Cailynoo7/makit-project-6/design/helicopter-lamp/README.md

# helicopter-lamp

## Must satisfy

## Making and assembly

## Open
