Cailynoo7/makit-project-6/design/keys/source/models/SOURCES.md

# SW1 mechanical reference

Exact identity Kinghelm KH-6X6X4.3H-STM/C2837530. Supplier footprint and electrical source are unchanged. This is an explicitly drawing-modeled conservative external envelope, not an original manufacturer STEP; arbitrary cover/lead detail does not define copper. Height H4.3mm, plunger diameter3.5mm, travel0.3+/-0.1mm come from the exact manufacturer drawing. The prior supplier STEP had5.01mm above its lead seating plane and is not the height authority.

Drawing URL: https://datasheet.lcsc.com/datasheet/pdf/3a63fc257cb630e20c8ec53c2547a77a.pdf?productCode=C2837530
Drawing SHA256:5686a865fc368784abc6e8805e710e62f4395d8b7a8c39ed3d3ddb1714d7a0b2

Generated by source-owned CAD design switch_reference, revision c9949165412c38a6ac5ab94769f7da9cb6df7377e4d89cbc662046b82f593c10, handoff export-7d7ee1b4b75383cb56aa28204cc8e3bd. Model lead seating plane is z0; overall height is4.3mm. Extra mounting gap parameter is0: the PCB exporter supplies its own mounting datum, which must not be counted twice. Model SHA256:80513fc8b36095e813428bed6e5761dc41643385bb0ecd3eed9ce8c9b031f12c

Internal project model; no third-party STEP licence claimed. Verify actual mounted height/press feel on first assembly.
