Cailynoo7/makit-project-6/product/铝件加工说明.md

# 一体金属热桥加工要求

本结构使用一件整体铝合金热桥，包含COB安装台、左右分支和贴壳接触面；不再分别加工或安装原AL01–15零件。历史15件加工图不适用于本结构。整体模型已通过几何和指定装配路径检查；作为加工规格仍须制造方确认工艺、可达性及报价。

默认沿用1050/1060铝材的导热用途。单件复杂曲面及薄接触区需要加工商确认可制造性、装夹、薄壁变形与报价；不把CAD单一实体视为制造工艺已确认。不要将塑料件或任意低导热材料替代金属件。

保持两处COB支座安装通孔、光源粘接面、螺钉头及工具避让。无需旧M1.6接触座螺纹和M2桥根夹紧螺纹。默认一般线性±0.10mm，孔位及配合接触尺寸±0.05mm，平面安装面平面度0.05mm；装配限制轮廓只能向少材料方向0.10mm。贴壳接触区不得加厚涂层或毛刺，去毛刺时不削薄接触边。

与塑料壳间保留薄层电绝缘非固化导热材料，COB与金属平台使用原绝缘导热胶。所有薄层厚度和实际接触压紧均需试装验证，不用厚胶补偿形状错误。三路温控和热稳定照度验收仍保留。
