Cailynoo7/makit-project-6/product/首样下单与供应商交样要求.md

# 自行制作首样的采购与检查

产品由用户自行制作、接线、烧录和装配，不购买厂家上下功能总成，不安排整机预装、代接线、代烧录或代校准。散件按采购清单购买。电芯选择带点焊引线规格，不在裸电芯上直接锡焊。

PCB沿用当前制造版本和原六层铜厚规格；裸板并不包含焊接元件。按元件方向、电源分区和结构化接线表自行焊接、检查短路及逐线导通。两个按键小板、三路NTC、灯驱动、电机限流和电池保护保留。

打印PETG壳体、托架、电池座及带集成承托的XIAO卡座；白色ASA反光罩与两只灯源支座一体打印，取消这两处胶接。单条25mm无扣绑带固定电池，端挡及两颗螺钉保留。充电试件使用与整机相同的集成承托高度，参考1.0mm板为0.6mm；实际1.6mm板用0mm。

15件铝件仍按同版STEP及已有加工图制作，材料1050/1060。保留金属攻牙、成形内衬和指定薄热界面，不能用打印件替代。散热片、热桥、探头均由用户安装。

按装配说明逐步组装，遵守主托架、电池座和侧窗的先后关系。合盖前确认旋翼自由转动、皮带不碰线、按钮无预压、USB可插拔、线束不被夹住。

通电后按已有校准与首样测试表记录实测数据：独立按键、USB关闭两负载、探头故障关闭、温控、灯扇同开、照度、风量、磁吸保持及振动。读写目标仍为300mm安装高、400×300mm区域平均500lx/最低300lx、最大最小比≤3，并要求热稳定后满足；当前未有实测通过记录。
