Cailynoo7/makit-project-6/product/function-review.md

# 风扇与灯功能核查

核查日期：2026-11-12。250mm旋翼的电机、传动、驱动及内部装配已形成可复算的理论方案；实际风量、噪声、温升和寿命仍未验证。阅读灯已选定具体COB、升压驱动及3200mAh18650；连接板电路与接线已更新并通过裸板制造检查；内部导热、电池固定、连接板托架及温度控制固件已实施并通过相应模型/程序检查，整灯光学与热稳定未验证，不能认定新版整机可直接采购装配运行。保持用户认可的外观。

## 风扇

- 供电：保护型1S电池分支→J_BAT→DRV8213RTER H桥→Pololu3060；XIAO只输出逻辑信号。新TPS61500照明支路独立，共用保护后电池。
- 选定Pololu3060、5:1 HPCB6V无编码器，厂家减速箱12×10mm、3mm D轴。6V空载6500rpm±20%、170mA±50%，理论堵转8.826mN·m、1.5A，最大机械功率约1.3W；这些不是单节电池下的输出。建议持续电流不超过额定堵转电流25%，即0.375A。
- 电机内部实际4.995:1，皮带有效轮径30/8mm、3.75:1，总减速18.73125:1。轴承及250mm四叶、37.5mm最大弦宽、1.6mm厚、12°桨距均不变。O形圈改32×1.5mm EPDM70A，中性线名义伸长5.526%；端板2颗M1.6×3，长孔允许±0.3mm微调。D轴承担扭矩，微量环氧点固只作轴向保持；先校准打印孔，不敲打电机轴。
- 可复算叶素动量模型使用显式假设的低雷诺数升阻系数，叠加近顶壁、轴承及皮带损耗，匹配厂家端点的单节电池外推曲线。60%驱动/制动PWM，在3.3/3.7/4.2V下名义旋翼411/458/514rpm、绕组电流0.261/0.276/0.297A。高负载敏感性算例4.2V电流约0.371A，已接近0.375A验收值；厂家空载电流和转速离散性尚未转为合格保证。不能直接启用100%占空比：名义满电估算795rpm、0.437A已超过持续电流建议。
- 皮带模型取弹性模量3–10MPa、摩擦系数0.3–0.7作假设敏感性，名义扭矩能力7.18mN·m，低假设2.73mN·m；实际硬度、松弛、污染和摩擦未测。名义电机径向负载约0.98N，同样需要寿命与轴套温升验证。不能把该估算当作O形圈厂家的性能保证。
- 驱动IN1接D3/GPIO5反相20kHz PWM，IN2接D5/GPIO7的J7.1使能；运行时IN2高、IN1高40%得到60%电机驱动与40%低侧制动，关闭两输入低至少10ms。新增D5/地线对完全在机舱内。按从上方看逆时针校准电机两线，形成向下送风。
- IMODE高、GAINSEL低、SMODE低，IPROPI4.99k，VREF为150k/22k分压；限流阈值3.3V约0.413A、4.2V约0.525A。470nF给出名义3.055s启动忽略窗口，之后过阈值会锁存关断；关闭再开复位，不自动反复启动。限流阈值不是持续电流额定值，也不能保护所有低于阈值的机械过载。
- 原RF300CA及同外形RF300FA只保留为比较证据，不列为现用动力。Pololu3060官网查询为待补货；通用N20不能按外形直接替代。

## 灯

- 已选成品COB光源：鸿利HL-LM002H384W-5B2C5(Ra2)(ANSI-4000K)，LCSC C22398553。自带铝基板13.5×13.5×1.5mm，发光面Ø11.2mm，4000K/Ra≥80。300mA、基板25℃下流明570/620/680，Vf14/16/18V；不能把这组目录光通量直接当成最终桌面照度。
- 新供电路径：18650→保险与1S保护→TPS61500升压恒流→COB，风扇走独立DRV8213分支。采样0.75Ω1%得267mA名义电流，含参考与电阻公差范围257–276mA，光源名义约4W。原MEL7135/Q2及旧1kHz50%程序不能使用该14–18V光源。
- 最坏计算采用LED电压18V再加3%测量容差、FB0.205V、效率80%、驱动输入3.0V、电感8µH和频率480kHz敏感性假设：输出5.175W，平均输入2.156A，开关峰值2.486A，小于芯片3A最小开关限流。整机另计风扇0.35A及主控0.12A，总预算2.626A。频率、效率、启动浪涌、限流和稳定性仍需样机确认。
- DIMC=1µF选择模拟调光，EN可接5kHz控制；启动必须先连续高电平50ms，再按温度降占空比。TI第11页写启动最小PWM导通200µs，不能用不足200µs的低占空比5kHz脉冲代替启动。关断保持EN低至少10ms。
- 读写目标默认30cm高、40×30cm区域平均≥500lx、最低≥300lx、最大/最小≤3。水平朗伯出光估算需要至少244lm有效向下光通量；260lm例子得到平均633lx、边角320lx。这是光学预算，并未证明最终打印罩和电池遮挡后能得到260lm。
- 热路径改为铝集热件、两条短宽铝导热带及实际72.1cm²贴壳均热片；不新增外孔或外露散热片。三点NTC及ADS1115监测灯源、壳面热点、电池。均热面积、接触热阻和壳面外侧换热尚未测定；降功率后的稳定亮度仍必须达到照度目标。
- 18650预留包络Ø19×66.2mm、横向Y轴、中心[0,0,-24]。相对现有结构的只读网格预检最小间隙约0.505mm，网格公差0.02mm；现版另有独立固定座、完整线束及分阶段装拆检查，见内部收尾评审。现版18×34×3mm集热板、ASA支座、桥和托架已完成实体适配，旧预检不用于现版验收。

## 共用能源、按钮与充电

- 使用XIAO ESP32C3自带Type-C与约380mA充电电路，不另加充电模块。用户已选3200mAh18650；具体电芯FLY.18650.3200.3C，最大Ø18.6×65.2mm、46g，裸电芯不带保护。供应商点焊引线，使用新版连接板BQ29700与并联背靠背MOS及4A熔断器；XIAO的BAT端、GND及负载全部接PACK侧，禁止电芯负极直接接XIAO绕过保护。电机与灯不从XIAO3.3V取电。原103040及1.5A保护电池采购要求已失效。灯单开约1.5–2小时、同时约1.2–1.6小时、充电约9–11小时均为估算。
- 左右各一块14×18mm按键板，J1.1=KEY、J1.2=GND；KH开关同侧A/B是一组，C/D是另一组。已修正接线表此前混用裸开关脚号的错误，不能把裸开关1与3当作两个不同触点。
- 充电检测已修正：R5上臂100k，R6下臂由100k改为150k、1%。5V时得到约3.0V；4.4V、最坏1%电阻公差时仍≥2.619V，高于3.3V GPIO的0.75VDD=2.475V保证高电平门槛。5.5V、最坏电阻公差时≤3.327V。GPIO10必须设置INPUT且不启用内部上拉/下拉；C4=100nF对应约6ms时间常数，程序采用高电平立即关断、低电平连续500ms后才解除禁止的处理。
- 程序已适配TPS61500的50ms连续启动/5kHz模拟调光，以及ADS1115三路NTC和电池电压采样；保留独立按键、DRV8213反相20kHz和USB负载关闭。35组测试/11329次断言通过，真实XIAO_ESP32C3编译通过（314386字节程序、14312字节静态RAM），未烧录或测波形。温度/ADC/探头/电压异常关闭负载，恢复需重新按键；程序不能停止原XIAO充电器。USB检测是软件互锁，不是硬件电源隔离。

## 验证与限制

- 旧连接板ade1797099dda888c56afeca8b9f904bfcdfbd4dd045d05e4b9c98c2fe10cd1c（不适用于新COB）：0DRC错误、0未连接项、7丝印警告，2层1oz，过孔0.6/0.3mm。制造和机械资料均已生成；元件仍按手工或委托回流焊装配，空的JLC SMT清单不构成包焊订单。WQFN散热焊盘及C5/C6地端过孔须检查焊接。
- 厂家电机STEP及新板装配模型已导入。已确认的外观未变，电机、托架、皮带轮及板均无新增静态相交；按键开关参考改为厂商H4.3mm图纸的保守装配外形，实板采购身份和焊盘不变；两侧顶杆留0.15mm空隙，0.45mm总位移对应0.30mm开关动作，止挡随内部压环拆卸。静态与按压/拆装路径未发现穿透，实际公差、回弹及手感仍需试件。
- 旋翼360°与托架带新电机的斜向检修路径均未见穿透；检查网格公差0.02mm，旋转最大点行程2mm、拆装0.5mm。完整线束现已按尺寸包络检查；打印误差与实物插合仍须确认。
- 新增两颗M1.6×3电机螺钉。承重M4×90 ISO10642的完全匹配现货仍需询价，不用圆柱头或DIN965替代。磁吸保持力、整机温升及光学性能未验证。

## 证据

- 现用电机：https://www.pololu.com/product/3060
- 电机厂家手册：https://www.pololu.com/file/0J1487/pololu-micro-metal-gearmotors-rev-6-2.pdf
- 驱动器：https://www.ti.com.cn/cn/lit/ds/symlink/drv8213.pdf
- XIAO供电与充电：https://wiki.seeedstudio.com/XIAO_ESP32C3_Getting_Started/
- XIAO引脚：https://files.seeedstudio.com/wiki/XIAO_WiFi/XIAO_ESP32-C3_front_pinout.png
- ESP32-C3数字输入电平：https://documentation.espressif.com/esp32-c3_datasheet_en.html
- MEL7135：https://datasheet.lcsc.com/datasheet/pdf/05432fb6d6b74673b053705b65285d53.pdf?productCode=C80214
- OSRAM候选灯珠：https://item.szlcsc.com/57658993.html
- OSRAM数据表（最大额定第4页、电特性第5页）：https://datasheet.lcsc.com/datasheet/pdf/4ebd874a5a3144677ed6206ea510a039.pdf?productCode=C54351703

控制程序及内部结构已同步，保持现有外观；下一步完成局部装配和探头校准。随后以实际透光罩进行热稳定照度、电池温升、充电关断和磁吸承载测试。硬件选型与计算可供改版使用，旧制造包不能直接制造新版阅读灯。

阅读灯证据与计算：COB、TPS61500、NTC及电芯供应商PDF均已归档；选型核查中逐项记录页码、原文与图示核对结果。

## 本版连接板验证

现版171fcced主板40×50×1.6mm、六层外1oz/内2oz、76器件完整模型保留。F1间隙0.715mm；J10/J11针脚未变。现版14只插座、H01–H12完整路线和21组分阶段检修已检查，详见内部光学与装配评审，不沿用旧临时线束末端或旧路线间隙数值。

## 当前收尾状态（2026-11-13）
采用现用171fcced主板与53c419c4按键板。保持已确认外观；本次只增加白ASA内反光罩、完整线束参考和可拆线束夹，修改卡座隐藏出线槽与铝桥R4线槽。静态104物体5356对零共享体积；12主板插壳和2窗端插座按分阶段0.5mm精确几何拔出检查无相交。21组刚性检修检查已复核，须断电并释放/停放柔性线。铝件15件、40.083g、内衬等效72.137cm²；前下透光口未改。

新资料可以用于首样加工询价和受控装配；未宣称光学/散热实测合格。固件既有主机和目标编译结果保留，接线仅追加路由标签；不改变引脚、温控或程序。必须以封壳热稳定照度、温度校准、旋翼绕组RMS电流/风量、磁吸承载验收实际首样。
