Cailynoo7/makit-project-6/product/reading-light-review.md

# 阅读灯光源、驱动、散热匹配

用户要求保持已确认的外观，独立照亮读书写字区域，取消20mm灯板与0.5W限制；用户选择3200mAh单节18650。本文落实器件和工程预算，连接板及接线已更新并通过裸板制造检查，电池座/导热CAD及温控固件已同步，实物热稳定照度尚未验证。

## 具体选型

|用途|选定身份|主要依据|
|---|---|---|
|成品COB光源|鸿利HL-LM002H384W-5B2C5(Ra2)(ANSI-4000K)，C22398553|自带铝基板13.5×13.5×1.5mm，发光面Ø11.2mm，4000K、Ra≥80；300mA、25℃下570/620/680lm，14/16/18V|
|恒流升压|TI TPS61500PWP，C1554283|输入2.9–18V，反馈200mV，3A最小开关限流；使用DIMC电容选择模拟调光|
|电感|奇力新MHCC06030-100M-R7，C280564|10µH±20%、DCR最大68mΩ、典型Isat5.5A/Irms4A；7.3×6.6×3mm|
|整流|Vishay SS3P6L-M3/86A，C968580|60V、3A肖特基，反压高于驱动芯片40V开关额定值|
|温度采集|TI ADS1115IDGSR，C37593|3.3V、四路ADC，三路NTC加电池电压|
|成品探头|宏嘉诚HNTC-103F3950FB-100P，C52204608，3个|10kΩ±1%、B3950K±1%、100mm引线；探头最大Ø2.8×7.5mm|
|电芯|远阳FLY.18650.3200.3C，C5289740|3200mAh典型、3100mAh最低，3.6V，最大Ø18.6×65.2mm，46g；裸电芯不含保护|
|电池保护|BQ29700DSER、5组并联CSD85301Q2背靠背MOS、0451004.MRL熔断器|过充、过放、过流及故障后备；XIAO及全部负载必须接保护后的PACK侧|

光源是工厂已封装在铝基板上的COB，无须用户另外寻找焊好裸灯珠的20mm星形板。小基板并不固定灯的低功率；本方案名义约4W，实际亮度由电流、光效、温度与透光系统共同决定。

电感供应商资料标注该系列不推荐新设计，允许现有库存原型使用，未作量产生命周期批准。各关键件暂无核验过的直接替换型号；原型须保持确切料号和COB的4000K/Ra2版本。查询时COB库存37、电芯72，库存会变化。

## 电气预算

- 0.75Ω±1%采样电阻配195–205mV反馈，名义266.7mA，范围257.4–276.1mA；采样耗散约0.057W，默认1206、至少0.25W。光源正常约4.1W，温度反馈按需降低电流。
- 最坏算例采用LED18V再加3%测量容差、反馈0.205V，输出约18.745V/5.175W；80%效率、驱动端3.0V时平均输入2.156A。8µH及480kHz敏感性假设下开关峰值2.486A，距3A最小开关限流约0.514A。600kHz实际频率离散、效率、偏置后电感值须实测；3A不是灯的输出电流。
- OVP分压158k/10k、均1%，包括基准误差为19.65–21.67V，高于上述输出；输出电容默认两颗2.2µF/50V、1210、X7R，需在21.7V下合计有效至少2.2µF。输入就近4.7µF/10V，SS47nF、COMP470nF、FREQ176kΩ，输出1MΩ泄放。普通阻容按这些公开默认值选标准封装，供应商偏压曲线在PCB落实时核对。
- DIMC接1µF；GPIO6/D4直接控制EN，减光时用5kHz。启动先连续高电平50ms再调光，关断至少低10ms。TI规定启动最小PWM导通200µs，不能把不足200µs的5kHz低占空比脉冲当成有效启动保证。
- 加风扇0.35A和主控0.12A余量，最坏电池电流预算2.626A，低于电芯全温区列出的3.1A持续电流。5组背靠背MOS并联用于降低单节电池栅压下的导通电阻；电流均分、热态电阻、保护动作与熔断器配合仍须验证。
- ADS1115使用AIN0灯源温度、AIN1壳体热点、AIN2电池温度、AIN3电池100k/100k分压；ADDR接地为0x48，100nF去耦，I²C上拉4.7kΩ。显式指定XIAO D7/GPIO20为SDA、D6/GPIO21为SCL，100kHz；默认I²C的GPIO6/7已被灯扇占用，不能直接沿用默认总线。
- 保留左右独立按钮及原DRV8213反相PWM，USB存在时关闭两负载，拔线稳定500ms后须重新按键。新增的是内部三线ADC接口、三路NTC接口和保护后XIAO电池线，不增加外部开口。

## 光学预算与验收

工程默认：透光底面距桌面30cm，40×30cm读写区，平均至少500lx、最低至少300lx、最大/最小不超过3。此矩形和高度不是GB/T9473认证测试声明。

用水平朗伯出光模型：`E=Φ有效·h²/[π(h²+x²+y²)²]`，401×301梯形网格积分得到每流明有效向下出光对应中心3.537lx、区域平均2.436lx、边角1.232lx，需至少243.54lm。260lm例子对应中心920lx、平均633lx、边角320lx，最大/最小2.87。

降低电流并考虑温度后的COB约400–500lm仅为工程估算。若源光400lm、65%成为有效向下出光，则上述预算可达标；若只有55%，边角约271lx，会失败。不能把65%耦合效率写成既成事实。光束需主要向下，内部白色反射件优先把光导向原底透光面，前透光面保持柔光；必须计入18650遮挡和打印透光罩损耗。原向前45°安装不继续作为阅读灯方向。

## 封闭机身的散热

保持无额外外孔及外露散热片。COB通过12×12×0.15mm绝缘导热胶接18×34×3mm集热板；经左右可拆铝桥、四只球面接触座及两只上盖连接件接六片0.5mm内衬。胶k≥1.5，非固化填料k≥3；多处0.1mm可拆热界面不得永久胶死。15件铝理论净重40.083g。

六片内衬体积/厚度等效面积72.137cm²，不是外部有效换热面积。旧180cm²构想的铝带/壳壁/外界换热数字已撤回，不作为现版估算。COB胶层一维理想热阻约0.694K/W，只是这一胶层，不能代替整条热路与局部热点实测。

默认灯源60℃开始降功率、70℃关闭，壳面43℃开始降功率、48℃关闭，电池40℃开始降功率、45℃关闭；三路传感器异常、ADC离线或电池低于3.3V关闭两路，恢复须重新按键。探头的安装热滞后需实测。XIAO原充电器没有已建立的软件充电关断接口，这些NTC逻辑关闭负载，不能冒称能停止充电；电芯充电环境仍要求0–45℃并验证实物温升。

必须把热稳定后的读写照度作为验收。连续记录至少60分钟且温升小于每10分钟1℃，测试灯单开与灯扇同时、满电与低电量、25℃并做35℃暖环境敏感性。若降功率后不达照度目标，继续改内部均热或光路，不能降低用户要求。

## 电池与内部装配

使用点焊包覆后Ø19×66.2mm的3200mAh电芯，轴Y、中心[0,0,-24]。独立托座、双绑带、缓冲端挡、硬定位与可拆端盖均已落实。COB、支座、桥、内衬、线束和安装件在现版静态检查无共享体积；分阶段拆装须先断电、解除绑扎并停放柔性支线。磁铁仍Ø30×2，须用完整样机重量及振动实测保持力。

约4W灯源下估算灯单开1.5–2小时、灯扇同时1.2–1.6小时；沿用XIAO约380mA充电，3200/380仅恒流阶段理想值8.42小时，含恒压及损耗预计9–11小时，均非实测承诺。

## 证据与实施边界

- COB供应商PDF第2–5页：基板、尺寸、电气/光学与温度曲线。
- TPS61500 PDF第3、5–6、10–15、18–19页：引脚、额定条件、模拟调光、外部元件及布局/热要求。
- 电芯PDF第4、7–8页：容量、外形、充放电条件与禁止直接焊接。
- ADS1115 PDF第3–5、11、23页：电平、模拟范围、总线及典型应用。
- NTC PDF第1、3页：电阻/B值、热响应及成品探头图。
- BQ29700 PDF第4–8、21–22页、CSD85301Q2第1、3–4页及4A熔断器第1–2页：保护、MOS连接和电阻、电流与熔断特性。熔断器目录I²t与PDF不一致，使用PDF的3.152A²s。
- XIAO引脚来自官方索引所载Espressif变体定义，D7=20、D6=21；程序需显式重映射I²C。

已将具体选型和计算同步到配件清单、约束及采购说明。连接板与接线已实施；内部电池座、导热组件、托架及温控程序已实施；下一项为实物装配、温度校准及热稳定照明验证。新版连接板裸板资料已生成，旧MEL7135制造包不得混用；现有固件已适配新COB/ADS1115/三路NTC，主机测试与XIAO目标编译通过，实物验证待完成。

## 当前内部收尾版本
反光罩/前混光口、完整线束和15件铝加工资料已落实到现版。铝净重40.083g；六片0.5mm内衬等效面积72.137cm²，任何180cm²概念的热阻结论不适用。反光罩哑白ASA厚1.6mm，16×2mm内部前混光口、25°遮光片；底透光片及前透光片尺寸不变。选取的4条COB至底片直线路径无遮挡，不代表光效或眩光验证。最终500lx/最低300lx/均匀性和热稳定必须用实物透光件检查。完整当前结论见内部光学与装配评审，旧概念和原始选型计算不作为现版热验收。
