Cailynoo7/makit-project-6/product/usb-fit-review.md

# 充电口与XIAO局部适配核查

2026-11-12。已取得并导入社区XIAO ESP32C3 STEP，完成模型装配和局部试件。仍需实物试装，社区模型不等于厂家尺寸认证。

## 模型来源与核对
来源：vinjocarsales/xiao-series0.1.7，assets/xiao-esp32-c3.step。
https://tscircuit.com/vinjocarsales/xiao-series/blob/assets/xiao-esp32-c3.step
下载：https://api.tscircuit.com/package_files/download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
SHA256：d3eb22a99dade7b2fb6ccc2ac102d9a5a5fac6c92ef4d58a8c496357b1ae3735。
模型31个实体，PCB20.955×17.78×1.0mm，整板含连接器22.463×17.78×4.21mm。板框与官方v1.3 PCB边界一致，连接器口沿相对板中心前伸11.9855mm，与官方USB0丝印平面包络吻合。不能用丝印替代实体机械图；此次高度取自社区STEP实际前口环面，尚未由实物证明。
官方wiki：https://wiki.seeedstudio.com/XIAO_ESP32C3_Getting_Started/
官方PCB：https://files.seeedstudio.com/wiki/XIAO_WiFi/Resources/XIAO_ESP32C3_v1.3_KiCad_260116.zip
官方工程文件名义板厚1.6mm，社区模型板厚1.0mm，版本差异未由实物确认。公开元件库未标模型许可，保留原来源，仅作项目装配参考。

## 定位与适配
外部开口中心保持[42.555111,0,-26.25]mm，仍比原位置上移10mm，插入方向+X。小口9.7×4.0mm，包胶凹位13.3×7.3mm、R0.5，中心处凹深4.75mm。
STEP原生板框中心X=1.8041587、横向中心Z=-6.1114，PCB下表面Y≈0；USB口沿X=13.7896587、口心Y=2.605。原生+Y为元件面、+X为USB方向。
板模型旋转X=90°，平移[24.01545264,-6.111399955,-28.855000015]，得到USB口心[37.805111,0,-26.25]，与设计接口目标重合。
卡座较此前沿机头方向移动1.4855mm，支承面抬高1.395mm，并加0.6mm可拆垫片。对模型中的1.0mm板，板下表面Z=-28.855、上表面Z=-27.855；实板若为1.6mm，不用0.6mm垫片，保持板顶面相同。夹槽总厚1.9mm，板+垫片总厚1.6mm，余量0.3mm。换板后还需检查是否同一连接器及元件布局。

## 局部试件
独立设计charging_fit，三件打印件：局部球壳、与整机相同的卡座、0.6mm垫片。两颗M1.6×5内六角机螺钉可复用整机件，主控板模型和螺钉不打印。
球壳约25.55×46×20.25mm；卡座约22.95×40×6.60mm；垫片20.5×17.2×0.6mm。
试件球壳与整机同一裁切区域的精确几何差为0；卡座、垫片与整机的双向体积差为0。比较使用整机0e3c71b快照，临时完整对比装配已从试件设计移除。

## 已完成的检查
- 整机参考板与机壳、卡座、垫片精确共同体积均为0；试件没有相交零件。
- 模型口心与目标坐标一致。参考板沿-X滑出25mm的路径无穿透；与卡座最小网格间隙约0.1304mm。
- 卡座连同板和垫片先-X10mm、后-Z20mm取出未见穿透；拆装路径0.5mm步长、0.02mm网格公差。
- 包胶量规15×12.35×6.5mm，横向±0.25mm、竖向±0.30mm四组合，推入20mm并以0.5mm取样，与试件壳体精确共同体积均为0。
- 按键供应商模型高度偏差已在后续4.3mm装配包络版本修正；按压实物手感仍须试件。

## 实物通过条件
用PETG按0.2mm层高试做三件，垫片为3层。装入裸板，1.0mm板加垫片、1.6mm板不加；从机头侧滑入板，勿强压板上器件。确认板边不晃、卡座无明显弯曲，再插入拟用直头USB数据线。插头须能完全就位，包胶不顶外壳，插拔不能带动卡座。随后检查USB供电/电脑枚举。插入力、端子接触、打印公差及焊线后的空间仍由实物试装确认。

## 本次同步
整机与局部卡座同时增加D6/D7/VBUS三处R1焊线槽，槽心[18.1361,±7.62]/[33.3761,-7.62]、Z=-26.2、高4.2mm。外部USB口和卡座最大包络不变。两者实体体积均622.533137mm³；试件当前4cdc95c5，整机47a887e8，原球壳和垫片未改。实物试装须带上最终焊线，确认出线槽不压线。
