Cailynoo7/makit-project-6/product/结构重构评审.md

# 左右分壳与单一内架结构重构

用户自行接线、组装，无厂家功能总成预装。六片独立均热片全部取消，原十五件散热金属件合并为一件连续金属热桥；电池鞍座、充电板支承、主板/电机承托和束线导向合并为一件PETG内架。反光罩因材料及光学功能保留为一件ASA零件。

|项目|重构前|重构后|减少|
|---|---:|---:|---:|
|散热金属件|15|1|14|
|热桥相关螺钉|8|2|6|
|独立支承件|4|1|3|
|充电板卡座螺钉|2|0|2|
|托座固定扎带|2|0|2|
|内架固定螺钉|2|1|1|
|合壳螺钉|3|2|1|
|尾梁螺钉|2|1|1|

相对重构前版本1ed13b5，独立结构件和紧固件共减少30件。消耗性胶带、胶层、线束端接及固化等待另计；XIAO导轨滑入后增加一处可剥离绝缘胶带止退。未测量装配时间，不把装配说明卡合并当作手工动作减少。

装配工作集中到壳外：主板、电机、电池、光学与热桥在线架上就位，接线检查后整架侧装，一个定位销与一颗M2×6固定。两颗M2×8沿左右方向拉紧拼缝，前上锁点经前口、后下锁点经底口操作；后部一体舌槽先定位；固定半壳独立承担顶部M4承重连接，开侧壳不松吊杆。尾梁短插头内置防转平面，一颗固定侧螺钉锁紧，外露圆肩不变。

指定装入、开壳、主板、热桥、电芯、端挡、充电板和螺钉路径的固定对象、前提及结果以结构化验证记录为准。网格公差0.02mm，路径采样最大步长0.5mm。柔性线束必须先断开、释放并停放，不能宣称会自动随刚性组件运动。工具检查同时考虑直达和六角扳手转动空间。

三路测温、电池保护、充电互锁、绝缘导热胶层和原读写照度要求全部保留。实体连续性和接触面积不能证明温升合格；平均500lx、最低300lx及均匀度不大于3的目标不降低。

这种减件方式把部分装配工作转移为复杂的一体金属件制造。整体热桥需要加工方确认成形/加工可达性、薄接触面变形和报价，不能按旧AL01–15图加工，也不能用塑料打印替代。未完成实物打印配合、装配用时、封壳温升、读写照度、风量噪声、旋翼平衡或磁吸振动测试。

## 锁壳连接核对

螺钉轴向从X改为Y，两半壳承靠面为Y=0，紧固件头部通过活动半壳压向固定半壳。后部舌槽提供约6mm导入，单边0.2mm间隙，约束X/Z错位；无需另装定位销或卡片。锁点分布在前上和后下，夹紧力不通过电池或主板。

从散件开始仍是两颗M2×8，无新增螺母或嵌件。检修需要取下前、底两片，不能再沿用只拆前片的顺序。按指定短臂工具检查旋转、螺纹退出和工具离开，手工放入及拿出已脱牙螺钉；实际扭矩、拉脱力及打印配合未实测。当前几何证据见case-closure-check，不把无碰撞当作强度认证。
