Cailynoo7/makit-project-6/product/gallery/cover.jpg

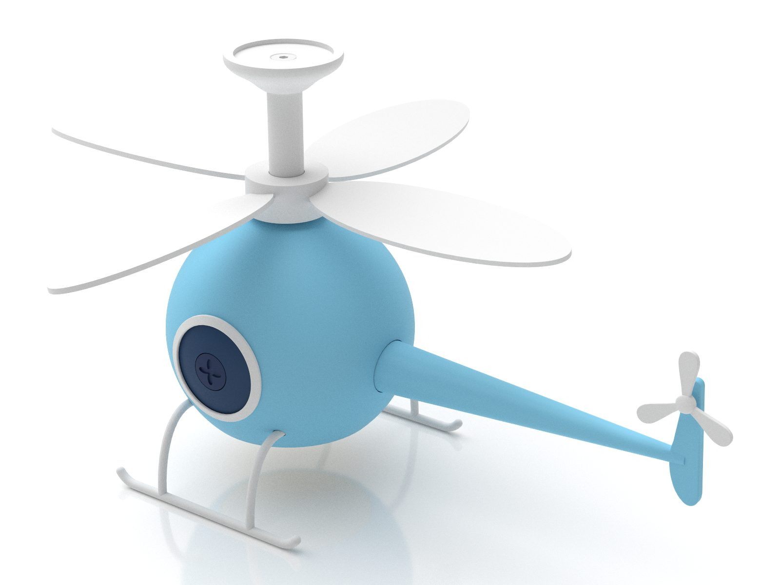
product/gallery/cover.jpg
