Cailynoo7/makit-project-6/product/打印清单.md

# 当前版本打印清单

一台整机：**31件**，其中PETG30件、哑白ASA1件。对应左右分壳、单一内架和一体金属热桥版本。可选USB试配件另外2件，不计入整机。

整套线束与插壳包络、板卡、电机、轴承、电池、螺钉、绑带、缓冲垫和胶层都不打印。铝热桥另行加工。**不要全选装配体导出打印。**

|打印对象|名称|数量|材料|颜色|装配姿态尺寸mm|
|---|---|---:|---|---|---|
|fuselage|固定侧机壳（负Y半壳）|1|PETG|天蓝|89.65 × 53.118 × 84.449|
|fuselage_cap|可拆侧机壳（正Y半壳）|1|PETG|天蓝|89.65 × 45.118 × 84.449|
|internal_carrier|单一内架，含电池鞍座、控制板承托及导线槽|1|PETG|白|72.27 × 69.4 × 62.7|
|battery_gate|可拆电池端挡|1|PETG|白|36.2 × 10.9 × 14.7|
|tail|一体尾梁与尾翼|1|PETG|天蓝|138.024 × 35.638 × 50.048|
|main_rotor|一体主旋翼|1|PETG|白|250.0 × 250.0 × 32.256|
|tail_propeller|装饰尾桨|1|PETG|白|35.571 × 7.688 × 31.735|
|skid_left|左右起落架，分别打印|1|PETG|白|93.75 × 30.325 × 31.625|
|skid_right|左右起落架，分别打印|1|PETG|白|93.75 × 30.325 × 31.625|
|window_left|左右不透明浅蓝窗面|1|PETG|浅蓝|42.6 × 15.608 × 42.6|
|window_right|左右不透明浅蓝窗面|1|PETG|浅蓝|42.6 × 15.608 × 42.6|
|button_left|灯与风扇按钮，分别打印|1|PETG|浅蓝|14.0 × 7.8 × 14.0|
|button_right|灯与风扇按钮，分别打印|1|PETG|浅蓝|14.0 × 7.788 × 14.0|
|window_bezel_left|左窗装饰外框|1|PETG|白|43.75 × 2.384 × 43.75|
|window_bezel_right|右窗装饰外框|1|PETG|白|43.75 × 2.384 × 43.75|
|window_retainer_left|左右窗内压环，分别打印|1|PETG|白|52.0 × 12.121 × 28.0|
|window_retainer_right|左右窗内压环，分别打印|1|PETG|白|52.0 × 12.121 × 28.0|
|skid_clamps_left|四处起落架根部曲面压帽|1|PETG|白|9.2 × 13.22 × 9.2|
|skid_clamp_right_aft|四处起落架根部曲面压帽|1|PETG|白|9.2 × 13.22 × 9.2|
|skid_clamps_right|四处起落架根部曲面压帽|1|PETG|白|9.2 × 13.22 × 9.2|
|skid_clamp_left_aft|四处起落架根部曲面压帽|1|PETG|白|9.2 × 13.22 × 9.2|
|bearing_pedestal|固定轴与轴承内圈承重支座|1|PETG|白|12.6 × 12.6 × 25.8|
|rotor_bearing_spacer|轴承外圈隔套|1|PETG|白|19.0 × 19.0 × 7.9|
|rotor_inner_spacer|轴承内圈隔套|1|PETG|白|12.6 × 12.6 × 7.9|
|hub_cover|主旋翼轴承压盖|1|PETG|白|32.5 × 32.5 × 6.95|
|mast|固定吊杆|1|PETG|白|13.5 × 13.5 × 41.0|
|magnet_base|磁吸顶部座|1|PETG|白|45.43 × 45.43 × 13.75|
|drive_pulley|电机D轴小带轮|1|PETG|白|9.8 × 9.8 × 4.0|
|nose_lens|前透光罩|1|PETG|半透明|9.563 × 58.815 × 58.815|
|belly_lens|底透光片|1|PETG|半透明|63.75 × 63.75 × 1.2|
|optical_reflector|一体反光罩及左右光源支座|1|ASA|哑白|25.0 × 46.0 × 25.0|

## 打印与试装

默认0.4mm喷嘴、0.2mm层高；PETG与ASA分开处理。两半壳以接缝面规划摆放，内侧导孔、定位舌和悬挑须检查支撑；内架的电池鞍座、侧孔和支杆使用局部支撑。窗压环后平面朝平台；白框的曲面胶合面不磨平。具体支撑及排版在切片软件确认，清单尺寸不是推荐打印方向。

主旋翼整件外廓250×250mm，需要大于250mm的可用打印面积及附加边缘空间；不能当作普通小平台已适配。先试配接缝与定位舌、导孔、窗肩、尾头、起落架根部和USB，再整机安装。前、底透光片均在锁紧两颗锁壳螺钉后安装，检修时两片都拆。

可选USB局部试配设计只打印 coupon_shell 和 controller_cassette 各1件；复用同一块XIAO，不额外买一块。两颗M1.6×5内六角螺钉仅供该试件使用。switch_reference 只用于开关对照，不属于打印清单。

设计页 Export → STL 或 3MF → 逐项勾选本表对象 → Export…。两片透光件单独用半透明PETG；其余窗面与按钮为不透明浅蓝。
