Cailynoo7/makit-project-6/product/bom.csv

id | name | platform_ref | quantity | source | selection_reason | part_identity | manufacturer | part_number | mpn | lcsc_code | supplier | stock | product_url | datasheet_url | package | jlc_smt_library | assembly | supply_risk | image_url | unit_price_cny | source_url | cad_model | designators | category | description | manufacturer_dimensions | fulfilment
controller | Seeed Studio XIAO ESP32C3 | seeed/xiao-esp32c3 | 1 |  |  |  |  |  |  |  |  |  |  |  |  |  |  |  |  |  |  |  |  |  |  |  | {"method": "buy", "scope": "finished_device"}
magnet | 圆片强力磁铁 Ø30×2 mm（用户指定） |  | 1 |  |  |  |  |  |  |  |  |  |  |  |  |  |  |  |  |  |  |  |  |  |  |  | {"method": "buy", "scope": "finished_device"}
connection_pcb | Custom40x50mm6-layer1.6mm PCB: TPS61500 COB + DRV8213 fan + ADS1115 temperature + BQ29700 protection |  | 1 | user | 40x50x1.6mm6layer,outer1oz/inner2oz;X40 and mounting holes(-16,-11),(16,-11) unchanged. J10/J11 row centres[13.35,5.3912]and[13.35,-4.9048],90degree rotation,pin1originX12.08,pin2X14.62, same pinout. Neighbouring passives,fan bias tap,inner2 sensor GND corridors and off-hole ground transfers updated;F1 relief and cable guides internal only. | df3f619804a92fdb |  |  |  |  |  |  |  |  |  |  |  |  |  |  |  |  |  |  |  |  | {"method": "buy", "scope": "finished_device"}
battery | FLY.18650.3200.3C |  | 1 | research | User selected3200mAh18650. FLY.18650.3200.3C is a bare3.6V cell,typ3200/min3100mAh,max18.6x65.2mm,46g. No built-in protection claimed. Supplier spot-welded tabs/leads plus the new PCB protection are required; no direct cell soldering. Datasheet pp4,7-8. | f86a160e22b1d79b | FLYOUNG(远阳) | FLY.18650.3200.3C | FLY.18650.3200.3C | C5289740 | LCSC | 72 | https://item.szlcsc.com/6029056.html | https://atta.szlcsc.com/upload/public/pdf/source/20221205/07E11C9A3B99BAAA3B7E607DC5FF771B.pdf | - | unknown | {"population": "not_mounted", "method": "module_mount"} | No approved drop-in alternate. Preserve exact MPN; recheck LCSC stock at purchase. Extended or unknown library is acceptable here because assembly is commissioned/manual, not a JLC SMT placement order. | https://alimg.szlcsc.com/upload/public/product/middle/20230105/B2E82B40C6A197EC38D59527C58C9F35.jpg | 19.98 |  |  |  |  |  |  | {"method": "buy", "scope": "finished_device"}
motor | Pololu 5:1 Micro Metal Gearmotor HPCB 6V (no encoder), item3060 |  | 1 | research | 12x10mm gearbox;3mm D-shaft;4.995:1 internal and3.75:1 belt reduction. Single-cell performance is extrapolated; initial60%PWM, winding current <=0.375A. Long-life carbon brushes; no interchangeable generic N20 accepted without matching motor curve. | 057639216d3fe995 | Pololu | 3060 | 3060 |  | Pololu | 0 | https://www.pololu.com/product/3060 | https://www.pololu.com/file/0J1487/pololu-micro-metal-gearmotors-rev-6-2.pdf |  |  |  | Official listing backordered at lookup; approximately USD26.45 before shipping. Domestic generic motors are not verified equivalents. |  |  | https://www.pololu.com/product/3060 | {"format": "step", "source_url": "https://www.pololu.com/file/0J2042/Pololu%20Micro%20Metal%20Gearmotor%203D%20%28STEP%29%20Models.zip", "file_name": "mmgm-cb.step"} |  |  |  |  | {"method": "buy", "scope": "finished_device"}
led_star | HL-LM002H384W-5B2C5(Ra2)(ANSI-4000K) |  | 1 | research | Finished COB light source on its own aluminium substrate,4000K,Ra>=80,13.5x13.5x1.5mm,LES11.2mm. At300mA,Tc25C:570/620/680lm and14/16/18V. Selected nominal266.7mA,approximately4W. The substrate size does not limit brightness to0.5W. Optical/thermal validation of the assembled lamp remains necessary. Datasheet pp2-5. | a8e5a947cc6b063a | HONGLITRONIC(鸿利光电) | HL-LM002H384W-5B2C5(Ra2)(ANSI-4000K) | HL-LM002H384W-5B2C5(Ra2)(ANSI-4000K) | C22398553 | LCSC | 37 | https://item.szlcsc.com/24012654.html | https://datasheet.lcsc.com/datasheet/pdf/7636cb76ede70875ee49a1607374b470.pdf?productCode=C22398553 | SMD,13.5x13.5mm | unknown | {"population": "not_mounted", "method": "module_mount"} | No approved drop-in alternate. Preserve exact MPN; recheck LCSC stock at purchase. Extended or unknown library is acceptable here because assembly is commissioned/manual, not a JLC SMT placement order. | https://assets.lcsc.com/images/lcsc/900x900/20240622_HONGLITRONIC-Hongli-Zhihui--HONGLITRONIC-HL-LM002H384W-5B2C5-Ra2-ANSI-4000K_C22398553_front.jpg | 3.21 |  |  |  |  |  |  | {"method": "buy", "scope": "finished_device"}
bearings | 6800 deep-groove ball bearing 10x19x5mm |  | 2 | research |  |  |  |  |  |  |  |  |  |  |  |  |  |  |  |  |  |  |  |  |  |  | {"method": "buy", "scope": "finished_device"}
headers_2 | 1x02 2.54mm vertical pin header, 2.54mm insulator, 6mm mating pin |  | 6 | default | J2 raw cell, J3 motor, J4 COB, J5/J6 keys, J7 fan enable; choose0.64mm square-pin2.54mm vertical family rated>=3A for power circuits. | df3f619804a92fdb |  |  |  |  |  |  |  |  |  |  | {"population": "mounted", "method": "manual"} |  |  |  |  |  | ["J2", "J3", "J4", "J5", "J6", "J7"] |  |  |  | {"method": "buy", "scope": "finished_device"}
headers_7 | 1x07 2.54mm vertical pin header, 2.54mm insulator, 6mm mating pin |  | 1 | default |  |  |  |  |  |  |  |  |  |  |  |  | {"population": "mounted", "method": "manual"} |  |  |  |  |  | ["J1"] |  |  |  | {"method": "buy", "scope": "finished_device"}
led_regulator | TPS61500PWP |  | 1 | research | TPS61500 analog-dimming boost topology,2.9-18V input,200mV feedback,3A minimum switch-current limit;3A is NOT LED output current. Rsense0.75ohm1%,nom266.7mA;DIMC1uF,EN5kHz. Selected for full1S discharge coverage and matched14-18V COB; obsolete MEL7135/Q2 path cannot drive this source. Datasheet pp3-6,10-15,18-19. | c71ff8cc23c281d9 | TI(德州仪器) | TPS61500PWP | TPS61500PWP | C1554283 | LCSC | 258 | https://item.szlcsc.com/1645090.html | https://datasheet.lcsc.com/datasheet/pdf/9766003e8b0d81036438896263c3df0e.pdf?productCode=C1554283 | HTSSOP-14-EP | extended | {"population": "mounted", "method": "manual"} | No approved drop-in alternate. Preserve exact MPN; recheck LCSC stock at purchase. Extended or unknown library is acceptable here because assembly is commissioned/manual, not a JLC SMT placement order. |  | 15.63 |  |  | ["U1"] |  |  |  | {"method": "buy", "scope": "finished_device"}
gate_resistors | 0603WAF1000T5E |  | 2 | research | R1 filtered DRV8213 VCC feed100ohm;R3 TPS61500 EN control series100ohm. | c89c362af0b7031b | UNI-ROYAL(厚声) | 0603WAF1000T5E | 0603WAF1000T5E | C22775 | LCSC | 16672 | https://item.szlcsc.com/23502.html | https://datasheet.lcsc.com/datasheet/pdf/0a975aaa49b7c97f38a963127be4a823.pdf?productCode=C22775 | 0603 | basic | {"population": "mounted", "method": "manual"} |  | https://assets.lcsc.com/images/lcsc/900x900/20251025_UNI-ROYAL-0603WAF1000T5E_C22775_front.jpg |  |  |  | ["R1", "R3"] |  |  |  | {"method": "buy", "scope": "finished_device"}
bias_resistors | RC0603FR-07100KL |  | 4 | research | R2 fan-input pulldown,R4 lamp EN pulldown,R5 USB sense divider top,R10 fan nFAULT pullup,100kohm each. | 417ab355c24bb59b | YAGEO(国巨) | RC0603FR-07100KL | RC0603FR-07100KL | C14675 | LCSC | 99743 | https://item.szlcsc.com/15343.html | https://datasheet.lcsc.com/datasheet/pdf/b426be3ce22c6de3e0c3a2248e49159e.pdf?productCode=C14675 | 0603 | extended | {"population": "mounted", "method": "manual"} |  | https://assets.lcsc.com/images/lcsc/900x900/20250410_YAGEO-RC0603FR-07100KL_C14675_front.jpg |  |  |  | ["R2", "R4", "R5", "R10"] |  |  |  | {"method": "buy", "scope": "finished_device"}
decoupling | CC0603KRX7R9BB104 |  | 5 | research |  | 793924b009c093b0 | YAGEO(国巨) | CC0603KRX7R9BB104 | CC0603KRX7R9BB104 | C14663 | LCSC | 18961 | https://item.szlcsc.com/15331.html | https://datasheet.lcsc.com/datasheet/pdf/23ccee80ee542e7cf156a772bb589942.pdf?productCode=C14663 | 0603 | basic | {"population": "mounted", "method": "manual"} |  | https://assets.lcsc.com/images/lcsc/900x900/20250715_YAGEO-CC0603KRX7R9BB104_C14663_front.jpg |  |  |  | ["C2", "C3", "C4", "C5", "C7"] |  |  |  | {"method": "buy", "scope": "finished_device"}
bulk | CL21A106KAYNNNE |  | 1 | research |  | 9c45cb58e1625d26 | SAMSUNG(三星) | CL21A106KAYNNNE | CL21A106KAYNNNE | C15850 | LCSC | 92206 | https://item.szlcsc.com/16532.html | https://datasheet.lcsc.com/datasheet/pdf/02336ea48ea44ca18c72517dd3cb7b47.pdf?productCode=C15850 | 0805 | basic | {"population": "mounted", "method": "manual"} |  | https://assets.lcsc.com/images/lcsc/900x900/20180914_Samsung-Electro-Mechanics-CL21A106KAYNNNE_C15850_front_10.jpg |  |  |  | ["C1"] |  |  |  | {"method": "buy", "scope": "finished_device"}
switches | KH-6X6X4.3H-STM |  | 2 | research |  | e4c01306691d06c6 | kinghelm(金航标) | KH-6X6X4.3H-STM | KH-6X6X4.3H-STM | C2837530 | LCSC | 635 | https://item.szlcsc.com/3009600.html | https://datasheet.lcsc.com/datasheet/pdf/3a63fc257cb630e20c8ec53c2547a77a.pdf?productCode=C2837530 | SMD-4P,6x6mm | extended | {"population": "mounted", "method": "manual"} |  | https://assets.lcsc.com/images/lcsc/900x900/20230120_Shenzhen-Kinghelm-Elec-KH-6X6X4-3H-STM_C2837530_front.jpg |  |  |  | ["SW1"] |  |  |  | {"method": "buy", "scope": "finished_device"}
drive_belt | EPDM70A O-ring,32mm inside diameter x1.5mm section, internal drive belt |  | 1 | default | Nominal5.53% neutral-line stretch at23mm centres,30/8mm pitch diameters. Hidden motor slots give+/-0.3mm adjustment. Choose actual preload by slip,current and bearing-temperature tests. | df3f619804a92fdb |  |  |  |  |  |  |  |  |  |  |  |  |  |  |  |  |  |  |  |  | {"method": "buy", "scope": "finished_device"}
led_spreader | One-piece aluminium COB thermal bridge with integral branches and shell-contact faces |  | 1 | default | Custom machined solid metal part;COB platform and both shell-contact branches are one piece. Replaces15 aluminium pieces,including6 separate liners;no separate thermal contact shoes or internal clamp screws. Keep electrically insulating thin shell TIM and COB bond. | df3f619804a92fdb |  |  |  |  |  |  |  |  |  |  |  |  |  |  |  |  |  |  |  |  | {"method": "machine", "scope": "finished_device"}
belly_diffuser | Printed translucent PETG belly diffuser, diameter 63.75mm, thickness 1.2mm |  | 1 | user |  |  |  |  |  |  |  |  |  |  |  |  |  |  |  |  |  |  |  |  |  |  | {"method": "print", "design_id": "helicopter", "object_ids": ["belly_lens"], "material": "PETG", "colour": "半透明", "scope": "finished_device"}
nose_diffuser | Printed translucent PETG nose diffuser, opening approximately59.5mm |  | 1 | default |  |  |  |  |  |  |  |  |  |  |  |  |  |  |  |  |  |  |  |  |  |  | {"method": "print", "design_id": "helicopter", "object_ids": ["nose_lens"], "material": "PETG", "colour": "半透明", "scope": "finished_device"}
button_caps | Opaque pale-blue curved Ø12mm button caps,Ø14mm internal flange,calibrated pusher,bulb/fan icons |  | 2 | user |  |  |  |  |  |  |  |  |  |  |  |  |  |  |  |  |  |  |  |  |  |  | {"method": "print", "design_id": "helicopter", "object_ids": ["button_left", "button_right"], "material": "PETG", "colour": "浅蓝", "scope": "finished_device"}
fixed_windows | Pale-blue curved window insert,37.5mm register,42.6mm shoulder,12.5mm button bore,open rear PCB guides |  | 2 | user | Pale-blue pane with37.5mm register,42.6mm shoulder; separate12mm button in12.5mm clearance hole; internal retaining ring; independent white overlay frame. | df3f619804a92fdb |  |  |  |  |  |  |  |  |  |  |  |  |  |  |  |  |  |  |  |  | {"method": "print", "design_id": "helicopter", "object_ids": ["window_left", "window_right"], "material": "PETG", "colour": "浅蓝", "scope": "finished_device"}
main_rotor_print | Printed white four-blade main rotor,diameter250mm,chord37.5mm,blade thickness1.6mm |  | 1 | default |  |  |  |  |  |  |  |  |  |  |  |  |  |  |  |  |  |  |  |  |  |  | {"method": "print", "design_id": "helicopter", "object_ids": ["main_rotor"], "material": "PETG", "colour": "白", "scope": "finished_device"}
skid_print | White90mm landing skid with curved struts and internally retained mounting roots |  | 2 | default | Curved struts; rail Z=-51.25mm,Y=+/-56.25mm; mounts X=+/-22.5mm,Z=-25mm;26.25mm vertical drop; front/rear symmetric; internally retained5mm pins. | df3f619804a92fdb |  |  |  |  |  |  |  |  |  |  |  |  |  |  |  |  |  |  |  |  | {"method": "print", "design_id": "helicopter", "object_ids": ["skid_left", "skid_right"], "material": "PETG", "colour": "白", "scope": "finished_device"}
tail_print | Solid sky-blue tail boom,50mm symmetric vertical fin,right half-profile trim,4mm cylindrical locating plug and circular shoulder |  | 1 | default | Solid circular taper,4mm-long locating plug with internal D-flat and circular bearing shoulder;one hidden axial M2 screw on fixed half. Visible round tail shoulder unchanged. | df3f619804a92fdb |  |  |  |  |  |  |  |  |  |  |  |  |  |  |  |  |  |  |  |  | {"method": "print", "design_id": "helicopter", "object_ids": ["tail"], "material": "PETG", "colour": "天蓝", "scope": "finished_device"}
tail_prop_print | Printed white three-blade decorative tail propeller, rounded paddle blades, domed hub and locating pin |  | 1 | default | White three-blade decorative left tail propeller; centre[176.875,-4.625,13.75]mm; aft offset1.875mm;3mm pin in3.5mm blind socket. | df3f619804a92fdb |  |  |  |  |  |  |  |  |  |  |  |  |  |  |  |  |  |  |  |  | {"method": "print", "design_id": "helicopter", "object_ids": ["tail_propeller"], "material": "PETG", "colour": "白", "scope": "finished_device"}
window_bezel_left_print | Printed white curved overlay window frame, left |  | 1 | default | Independent white PETG ring covering pale-blue window edge by 0.5mm; curved back follows cabin surface with nominal 0.15mm glue allowance; free curved adhesive interface. | df3f619804a92fdb |  |  |  |  |  |  |  |  |  |  |  |  |  |  |  |  |  |  |  |  | {"method": "print", "design_id": "helicopter", "object_ids": ["window_bezel_left"], "material": "PETG", "colour": "白", "scope": "finished_device"}
window_bezel_right_print | Printed white curved overlay window frame, right |  | 1 | default | Independent white PETG ring covering pale-blue window edge by 0.5mm; curved back follows cabin surface with nominal 0.15mm glue allowance; free curved adhesive interface. | df3f619804a92fdb |  |  |  |  |  |  |  |  |  |  |  |  |  |  |  |  |  |  |  |  | {"method": "print", "design_id": "helicopter", "object_ids": ["window_bezel_right"], "material": "PETG", "colour": "白", "scope": "finished_device"}
internal_carrier_print | PETG single internal chassis with integral battery cradle,XIAO support,motor/PCB mounts and loom guide |  | 1 | default | One PETG chassis integrates battery cradle,motor/PCB mounts,XIAO rails and open loom guide. One front locator and oneM2x6 clamp. XIAO slides from rear on bench;one removable insulating-tape tab retains it axially. | df3f619804a92fdb |  |  |  |  |  |  |  |  |  |  |  |  |  |  |  |  |  |  |  |  | {"method": "print", "design_id": "helicopter", "object_ids": ["internal_carrier"], "material": "PETG", "colour": "白", "scope": "finished_device"}
internal_mount_screws | M2x6mm ISO4762 stainless steel socket-head screw |  | 1 | default | Single rear horizontal chassis clamp plus front locating pin;length verified by screw-joint build. | 709e80c88487a241 |  |  |  |  |  |  |  |  |  |  |  |  |  |  |  |  |  |  |  |  | {"method": "buy", "scope": "finished_device"}
battery_strap | 25mm wide buckle-free double-sided hook-and-loop tape,<=0.8mm single layer,cut75mm |  | 1 | default | One 25mm strap centred Y=0 replaces two 10mm straps;cradle groove widened to26mm. Top overlap only;axial end gate and two buffers retained. | df3f619804a92fdb |  |  |  |  |  |  |  |  |  |  |  |  |  |  |  |  |  |  |  |  | {"method": "buy", "scope": "finished_device"}
battery_foam | PET/polyimide insulating contact film,0.1mm thick,10x20mm |  | 2 | default | Include films,wrap and welded tabs within the reserved19x66.2mm pack envelope;do not add a70mm protected-cell variant. | df3f619804a92fdb |  |  |  |  |  |  |  |  |  |  |  |  |  |  |  |  |  |  |  |  | {"method": "buy", "scope": "finished_device"}
pcb_mount_screws | M2 x 4mm ISO 7045 pan-head stainless steel machine screw |  | 2 | default |  |  |  |  |  |  |  |  |  |  |  |  |  |  |  |  |  |  |  |  |  |  | {"method": "buy", "scope": "finished_device"}
key_headers | 1x02 2.54mm vertical pin header for window daughterboard |  | 2 | default |  |  |  |  |  |  |  |  |  |  |  |  | {"population": "mounted", "method": "through_hole", "side": "bottom"} |  |  |  |  |  |  |  |  |  | {"method": "buy", "scope": "finished_device"}
key_pcbs | Window button daughterboard,14x18mm,2-layer FR41.6mm |  | 2 | default |  |  |  |  |  |  |  |  |  |  |  |  |  |  |  |  |  |  |  |  |  |  | {"method": "buy", "scope": "finished_device"}
drive_pulley_print | White PETG D-shaft pulley,8mm effective diameter,3mm bore with flat at1mm; calibrate fit and spot-epoxy axial retention |  | 1 | default |  |  |  |  |  |  |  |  |  |  |  |  |  |  |  |  |  |  |  |  |  |  | {"method": "print", "design_id": "helicopter", "object_ids": ["drive_pulley"], "material": "PETG", "colour": "白", "scope": "finished_device"}
led_thermal_adhesive | Electrically insulating thermal adhesive,k>=1.5W/mK,bond line0.10-0.15mm |  | 1 | default | Thin bond to finished COB metal substrate;keep light-emitting area and terminals clean. Thermal contact resistance target<=0.75K/W. | df3f619804a92fdb |  |  |  |  |  |  |  |  |  |  |  |  |  |  |  |  |  |  |  |  | {"method": "buy", "scope": "finished_device"}
tail_lock_screws | M2x5mm ISO4762 stainless steel socket-head cap screw |  | 1 | default | One hidden screw on fixed negative-Y half;D-flat short plug supplies anti-rotation. | df3f619804a92fdb |  |  |  |  |  |  |  |  |  |  |  |  |  |  |  |  |  |  |  |  | {"method": "buy", "scope": "finished_device"}
service_screws | M2x8mm ISO4762 stainless steel socket-head screw |  | 2 | default | Two M2x8 normal-Y case clamps,front-upper and rear-lower;kit-generated4mm engagement. Integral rear tongue/groove aligns before clamping. Front and bottom diffusers must both be removed for access;no separate locating parts,new exterior holes,nuts or inserts. | df3f619804a92fdb |  |  |  |  |  |  |  |  |  |  |  |  |  |  |  |  |  |  |  |  | {"method": "buy", "scope": "finished_device"}
controller_mount_screws | M1.6x5mm ISO4762 stainless steel socket-head cap screw |  | 2 | default | Optional charging-fit coupon only;main XIAO support is integral and uses no separate mounting screws. | df3f619804a92fdb |  |  |  |  |  |  |  |  |  |  |  |  |  |  |  |  |  |  |  |  | {"method": "buy", "scope": "optional_fit_test"}
heat_mount_screws | M1.6x5mm ISO7045 stainless steel pan-head screw |  | 2 | default | Through3mm aluminium collector into kit-generated ASA pilot joints;do not substitute the former4mm length. | df3f619804a92fdb |  |  |  |  |  |  |  |  |  |  |  |  |  |  |  |  |  |  |  |  | {"method": "buy", "scope": "finished_device"}
fuselage_lower_print | Sky-blue PETG fixed negative-Y cabin half with integral locating tongue and normal-Y clamp receivers |  | 1 | default | One fixed side shell;integral rear locating tongue and two normal-Y M2x8 receiver bosses. Printed from fuselage only;metal hardware is purchased separately. | df3f619804a92fdb |  |  |  |  |  |  |  |  |  |  |  |  |  |  |  |  |  |  |  |  | {"method": "print", "design_id": "helicopter", "object_ids": ["fuselage"], "material": "PETG", "colour": "天蓝", "scope": "finished_device"}
fuselage_cap_print | Sky-blue PETG removable positive-Y cabin half with integral locating groove and normal-Y clamp ears |  | 1 | default | One removable side shell;integral locating groove and two through ears. No separate locating parts;front and belly diffusers fitted after tightening both case screws. | df3f619804a92fdb |  |  |  |  |  |  |  |  |  |  |  |  |  |  |  |  |  |  |  |  | {"method": "print", "design_id": "helicopter", "object_ids": ["fuselage_cap"], "material": "PETG", "colour": "天蓝", "scope": "finished_device"}
led_bracket_screws | M1.6x4mm ISO7045 stainless steel pan-head screw |  | 2 | default |  |  |  |  |  |  |  |  |  |  |  |  |  |  |  |  |  |  |  |  |  |  | {"method": "buy", "scope": "finished_device"}
window_retainer_print | White PETG curved-window clamp with integrated removable button stop,PCB rear pads and lower ledge |  | 2 | default | Internal U-ring and curved saddle feet clamp each pane shoulder against the100mm cabin; twoM2x6 per window. | df3f619804a92fdb |  |  |  |  |  |  |  |  |  |  |  |  |  |  |  |  |  | mechanical |  |  | {"method": "print", "design_id": "helicopter", "object_ids": ["window_retainer_left", "window_retainer_right"], "material": "PETG", "colour": "白", "scope": "finished_device"}
window_retainer_screws | M2x6mm ISO4762 stainless steel socket-head cap screw |  | 4 | default | Four internal M2x6 socket-cap screws, two per pane; kit-derived nominal geometry, printed fit still needs coupon. | df3f619804a92fdb |  |  |  |  |  |  |  |  |  |  |  |  |  |  |  |  |  | mechanical |  |  | {"method": "buy", "scope": "finished_device"}
skid_root_caps_print | White PETG curved internal saddle cap,9.2mm OD,6.7mm peg cavity,quantity4 |  | 4 | default | Four independently printable curved saddle caps,9.2mm OD,6.7mm cavity; two per skid, matching the sphere interior. | df3f619804a92fdb |  |  |  |  |  |  |  |  |  |  |  |  |  |  |  |  |  | mechanical |  |  | {"method": "print", "design_id": "helicopter", "object_ids": ["skid_clamps_left", "skid_clamp_right_aft", "skid_clamps_right", "skid_clamp_left_aft"], "material": "PETG", "colour": "白", "scope": "finished_device"}
skid_root_screws | M2x8mm ISO4762 stainless steel socket-head cap screw |  | 4 | default | Four M2x8 socket-cap screws into5mm locating pins; internal heads; kit-derived nominal geometry, printed fit still needs coupon. | df3f619804a92fdb |  |  |  |  |  |  |  |  |  |  |  |  |  |  |  |  |  | mechanical |  |  | {"method": "buy", "scope": "finished_device"}
rotor_bearing_spacer_print | PETG bearing outer-race spacer,19mm OD,16mm ID,7.9mm long |  | 1 | default | 7.9mm spacer bears only on the two6800 outer races; separate from stationary inner spacer. | df3f619804a92fdb |  |  |  |  |  |  |  |  |  |  |  |  |  |  |  |  |  | mechanical |  |  | {"method": "print", "design_id": "helicopter", "object_ids": ["rotor_bearing_spacer"], "material": "PETG", "colour": "白", "scope": "finished_device"}
rotor_inner_spacer_print | PETG bearing inner-race spacer,12.6mm OD,10.2mm ID,7.9mm long |  | 1 | default |  |  |  |  |  |  |  |  |  |  |  |  |  |  |  |  |  |  |  |  |  |  | {"method": "print", "design_id": "helicopter", "object_ids": ["rotor_inner_spacer"], "material": "PETG", "colour": "白", "scope": "finished_device"}
suspension_bolt | M4x90mm ISO10642 stainless steel countersunk socket screw |  | 1 | default |  |  |  |  |  |  |  |  |  |  |  |  |  |  |  |  |  |  |  |  |  |  | {"method": "buy", "scope": "finished_device"}
suspension_nut | M4 ISO4032 stainless steel hex nut |  | 1 | default |  |  |  |  |  |  |  |  |  |  |  |  |  |  |  |  |  |  |  |  |  |  | {"method": "buy", "scope": "finished_device"}
bearing_retaining_adhesive | Bearing-retaining adhesive compatible with PETG and steel; bond only outer races to rotor hub |  | 1 | default |  |  |  |  |  |  |  |  |  |  |  |  |  |  |  |  |  |  |  |  |  |  | {"method": "buy", "scope": "finished_device"}
magnet_base_print | White PETG magnetic cup,45mm OD,13.75mm high,30.3mm pocket1.5mm deep |  | 1 | default |  |  |  |  |  |  |  |  |  |  |  |  |  |  |  |  |  |  |  |  |  |  | {"method": "print", "design_id": "helicopter", "object_ids": ["magnet_base"], "material": "PETG", "colour": "白", "scope": "finished_device"}
mast_print | White PETG stepped hollow mast,visible13.5x33.95mm,12.6mm inner-race foot7.05mm long |  | 1 | default |  |  |  |  |  |  |  |  |  |  |  |  |  |  |  |  |  |  |  |  |  |  | {"method": "print", "design_id": "helicopter", "object_ids": ["mast"], "material": "PETG", "colour": "白", "scope": "finished_device"}
rotor_fixed_axle_print | White PETG9.8mm fixed axle with12.6mm lower inner-race shoulder,4.6mm bolt bore |  | 1 | default |  |  |  |  |  |  |  |  |  |  |  |  |  |  |  |  |  |  |  |  |  |  | {"method": "print", "design_id": "helicopter", "object_ids": ["bearing_pedestal"], "material": "PETG", "colour": "白", "scope": "finished_device"}
hub_cover_print | White PETG32.5mm rotor hub cover with integral outer-race retainer |  | 1 | default |  |  |  |  |  |  |  |  |  |  |  |  |  |  |  |  |  |  |  |  |  |  | {"method": "print", "design_id": "helicopter", "object_ids": ["hub_cover"], "material": "PETG", "colour": "白", "scope": "finished_device"}
diffuser_reversible_adhesive | Peelable elastic adhesive compatible with PETG for curved front and belly diffusers |  | 1 | default |  |  |  |  |  |  |  |  |  |  |  |  |  |  |  |  |  |  |  |  |  |  | {"method": "buy", "scope": "finished_device"}
usb_sense_bottom | 0603WAF1503T5E |  | 2 | research | Two150kohm resistors:R6 USB sense bottom andR7 fan VREF divider top. | a768158e90bf6980 | UNI-ROYAL(厚声) | 0603WAF1503T5E | 0603WAF1503T5E | C22807 | LCSC | 4732 | https://item.szlcsc.com/23534.html | https://datasheet.lcsc.com/datasheet/pdf/0a975aaa49b7c97f38a963127be4a823.pdf?productCode=C22807 | 0603 | basic | {"population": "mounted", "method": "manual"} |  | https://assets.lcsc.com/images/lcsc/900x900/20251009_UNI-ROYAL-0603WAF1503T5E_C22807_front.jpg |  |  |  | ["R6", "R7"] |  |  |  | {"method": "buy", "scope": "finished_device"}
female_housing_2 | 2.54mm1x02 narrow female crimp housing,maximum5.6x3x14mm |  | 7 | default | Seven mainboard housings:J2,J3,J4,J5,J6,J7,J12;14mm total installed height. Side-window ends are separate low-profile solder sockets;do not buy nine standard crimp housings. | df3f619804a92fdb |  |  |  |  |  |  |  |  |  |  |  |  |  |  |  |  |  |  |  |  | {"method": "buy", "scope": "finished_device"}
female_housing_7 | 2.54mm1x07 narrow female crimp housing,maximum3x18.3x14mm |  | 1 | default | J1;0.64mm square mating pins,7contacts;wire fanout to XIAO solder pads. | df3f619804a92fdb |  |  |  |  |  |  |  |  |  |  |  |  |  |  |  |  |  |  |  |  | {"method": "buy", "scope": "finished_device"}
female_contacts | Matching female crimp contacts for0.64mm square pin,24-26AWG |  | 24 | default | 24 loose matching crimp contacts=7x2+7+3 for mainboard generic housings;window sockets include their own4contacts;three TE probe plugs use separate6TE contacts. >=3A for power contacts. | df3f619804a92fdb |  |  |  |  |  |  |  |  |  |  |  |  |  |  |  |  |  |  |  |  | {"method": "buy", "scope": "finished_device"}
power_wire | 24AWG flexible insulated copper wire,OD<=1.4mm,red1m+black1m |  | 1 | default | 24AWG red1m+black1m for protected PACK,motor and shared GND;raw cell leads supplied by spot-weld service. Finished cuts in harness table;no RAW negative Y split. | df3f619804a92fdb |  |  |  |  |  |  |  |  |  |  |  |  |  |  |  |  |  |  |  |  | {"method": "buy", "scope": "finished_device"}
signal_wire | 26AWG flexible insulated copper wire,OD<=1.1mm,total4m including>=0.5m white |  | 1 | default | H01/H04/H05/H06/H07/H08 stock;total4m includes>=0.5m white for visible optical cavity. Finished26AWG OD<=1.1mm to match fanout/tip envelopes;NTC adapter OD0.89-1.4mm as separately specified. White COB insulation uses red/yellow end labels,not an extra thick sleeve. | df3f619804a92fdb |  |  |  |  |  |  |  |  |  |  |  |  |  |  |  |  |  |  |  |  | {"method": "buy", "scope": "finished_device"}
usb_cable | USB Type-C data+charge cable1m,slim plug body at most12.35x6.5mm at enclosure entry |  | 1 | default |  |  |  |  |  |  |  |  |  |  |  |  |  |  |  |  |  |  |  |  |  |  | {"method": "buy", "scope": "finished_device"}
usb_adapter | Regulated5V USB power supply,at least1A,matching USB cable |  | 1 | default |  |  |  |  |  |  |  |  |  |  |  |  |  |  |  |  |  |  |  |  |  |  | {"method": "buy", "scope": "finished_device"}
magnet_adhesive | Thin-bond two-part epoxy compatible with PETG and nickel-plated NdFeB,small kit |  | 1 | default |  |  |  |  |  |  |  |  |  |  |  |  |  |  |  |  |  |  |  |  |  |  | {"method": "buy", "scope": "finished_device"}
heatshrink | Heat shrink tube assortment1-4mm,small pack |  | 1 | default |  |  |  |  |  |  |  |  |  |  |  |  |  |  |  |  |  |  |  |  |  |  | {"method": "buy", "scope": "finished_device"}
insulation_tape | Polyimide insulating tape,10mm wide,one roll |  | 1 | default |  |  |  |  |  |  |  |  |  |  |  |  |  |  |  |  |  |  |  |  |  |  | {"method": "buy", "scope": "finished_device"}
solder_consumables | Electronics solder+flux,small manual assembly kit |  | 1 | default |  |  |  |  |  |  |  |  |  |  |  |  |  |  |  |  |  |  |  |  |  |  | {"method": "buy", "scope": "finished_device"}
charging_fit_shell_print | Optional USB fit-test print set: local coupon shell x1 and test XIAO cassette x1 |  | 1 | default | Test fixture only;main unit uses integral chassis rails. Two M1.6x5 screws belong to coupon,not final lamp. | df3f619804a92fdb |  |  |  |  |  |  |  |  |  |  |  |  |  |  |  |  |  |  |  |  | {"method": "print", "scope": "optional_fit_test", "design_id": "charging_fit", "object_ids": ["coupon_shell", "controller_cassette"], "material": "PETG", "quantity_unit": "set"}
fan_driver | DRV8213RTER |  | 1 | research | Current regulation and latched stall shutdown at1S voltage; no Basic candidate with the same functions was found. WQFN requires reflow assembly. | fd0f98923f06b2f6 | TI(德州仪器) | DRV8213RTER | DRV8213RTER | C31829946 | LCSC | 315 | https://item.szlcsc.com/33567428.html | https://www.ti.com.cn/cn/lit/ds/symlink/drv8213.pdf | WQFN-16-EP(3x3) | extended | {"population": "mounted", "method": "manual"} |  | https://assets.lcsc.com/images/lcsc/900x900/20260228_TI-DRV8213RTER_C31829946_front.jpg |  |  |  | ["U2"] |  | 具有集成电流检测、电流调节和失速检测功能的4A有刷直流电机驱动器 |  | {"method": "buy", "scope": "finished_device"}
fan_current_scale | 0603WAF4991T5E |  | 1 | research | 4.99k IPROPI resistor; AIPROPI205uA/A. | 8d35cea5d2708bde | UNI-ROYAL(厚声) | 0603WAF4991T5E | 0603WAF4991T5E | C23046 | LCSC | 12311 | https://item.szlcsc.com/23773.html | https://datasheet.lcsc.com/datasheet/pdf/0a975aaa49b7c97f38a963127be4a823.pdf?productCode=C23046 | 0603 | basic | {"population": "mounted", "method": "manual"} |  | https://alimg.szlcsc.com/upload/public/product/middle/20221228/1B8B71093E88E17E066B810DDA7DEB84.jpg |  |  |  | ["R9"] |  | 4.99kΩ ±1% 100mW 0603 Thick Film Resistor |  | {"method": "buy", "scope": "finished_device"}
fan_vref_bottom | 0603WAF2202T5E |  | 1 | research | 22k bottom with150k top gives VREF=VBAT*22/172. | 87defe7f967dadbb | UNI-ROYAL(厚声) | 0603WAF2202T5E | 0603WAF2202T5E | C31850 | LCSC | 13104 | https://item.szlcsc.com/32812.html | https://datasheet.lcsc.com/datasheet/pdf/0a975aaa49b7c97f38a963127be4a823.pdf?productCode=C31850 | 0603 | basic | {"population": "mounted", "method": "manual"} |  | https://alimg.szlcsc.com/upload/public/product/middle/20251013/B224F7A864E47E44EFFD65D2C0C0EEFC.jpg |  |  |  | ["R8"] |  | 22kΩ ±1% 100mW 0603 Thick Film Resistor |  | {"method": "buy", "scope": "finished_device"}
fan_start_timer | CL10B474KA8NNNC |  | 1 | research | 470nF timer: nominal3.055s startup blanking. | b716255ee5ac5e29 | SAMSUNG(三星) | CL10B474KA8NNNC | CL10B474KA8NNNC | C1623 | LCSC | 15436 | https://item.szlcsc.com/1975.html | https://datasheet.lcsc.com/datasheet/pdf/02336ea48ea44ca18c72517dd3cb7b47.pdf?productCode=C1623 | 0603 | basic | {"population": "mounted", "method": "manual"} |  | https://assets.lcsc.com/images/lcsc/900x900/20250904_Samsung-Electro-Mechanics-CL10B474KA8NNNC_C1623_front.jpg |  |  |  | ["C6"] |  | 470nF ±10% 25V Ceramic Capacitor X7R 0603 |  | {"method": "buy", "scope": "finished_device"}
fan_bulk | CL31A476MPHNNNE |  | 1 | research | 47uF10V1206 local motor input bulk; capacitance under DC bias must be checked on prototype. | d75d2b09d9438e4d | SAMSUNG(三星) | CL31A476MPHNNNE | CL31A476MPHNNNE | C96123 | LCSC | 6739 | https://item.szlcsc.com/97327.html | https://datasheet.lcsc.com/datasheet/pdf/02336ea48ea44ca18c72517dd3cb7b47.pdf?productCode=C96123 | 1206 | basic | {"population": "mounted", "method": "manual"} |  | https://assets.lcsc.com/images/lcsc/900x900/20240318_Samsung-Electro-Mechanics-CL31A476MPHNNNE_C96123_front.jpg |  |  |  | ["C8"] |  | 47uF ±20% 10V Ceramic Capacitor X5R 1206 |  | {"method": "buy", "scope": "finished_device"}
motor_mount_screws | ISO4762 M1.6x3 socket head cap screw, stainless |  | 2 | default | Through2mm motor plate into existing threaded metal gearbox;1mm engagement. | df3f619804a92fdb |  |  |  |  |  |  |  |  |  |  |  |  |  |  |  |  |  |  |  |  | {"method": "buy", "scope": "finished_device"}
motor_pulley_epoxy | Two-part epoxy adhesive suitable for PETG and steel, small tube |  | 1 | default | Spot at exposed D-shaft/pulley end provides axial retention only. Do not bond motor bearing or gearbox; replace pulley and motor together for service. | df3f619804a92fdb |  |  |  |  |  |  |  |  |  |  |  |  |  |  |  |  |  |  |  |  | {"method": "buy", "scope": "finished_device"}
led_inductor | MHCC06030-100M-R7 |  | 1 | research | MHCC06030-100M-R7 shielded10uH20%,DCR68mohm max,Isat5.5A typ at30% inductance drop,Irms4A typ at40C rise;7.3x6.6x3mm. At8uH and assumed480kHz low-frequency bound,calculated worst switch peak2.49A. Supplier datasheet pp2,17 marks series not for new design; accepted for limited-stock prototype,requires lifecycle substitution review before production. | 5150237d3fe3006c | Chilisin(奇力新) | MHCC06030-100M-R7 | MHCC06030-100M-R7 | C280564 | LCSC | 568 | https://item.szlcsc.com/266984.html | https://datasheet.lcsc.com/datasheet/pdf/19fc53f9b3116f21fa52dfafc921b9d8.pdf?productCode=C280564 | SMD,7.3x6.6mm | extended | {"population": "mounted", "method": "manual"} | No approved drop-in alternate. Preserve exact MPN; recheck LCSC stock at purchase. Extended or unknown library is acceptable here because assembly is commissioned/manual, not a JLC SMT placement order. | https://assets.lcsc.com/images/lcsc/900x900/20181009_Chilisin-Elec-MHCC06030-100M-R7_C280564_front.jpg | 1.369 |  |  | ["L1"] |  |  |  | {"method": "buy", "scope": "finished_device"}
led_schottky | SS3P6L-M3/86A |  | 1 | research | SS3P6L-M3/86A,60V3A,TO-277A,chosen from TPS61500 recommended diode family; reverse rating exceeds40V switch rating. AverageLED current<=0.277A; calculated inductor peak2.49A. Datasheet pp1-2; footprint/polarity to be checked in PCB revision. | 41c6c2dbcf61d42b | VISHAY(威世) | SS3P6L-M3/86A | SS3P6L-M3/86A | C968580 | LCSC | 128 | https://item.szlcsc.com/1056014.html | https://datasheet.lcsc.com/datasheet/pdf/163a247b336f0b75cd6b5a9b78459285.pdf?productCode=C968580 | TO-277A | extended | {"population": "mounted", "method": "manual"} | No approved drop-in alternate. Preserve exact MPN; recheck LCSC stock at purchase. Extended or unknown library is acceptable here because assembly is commissioned/manual, not a JLC SMT placement order. | https://assets.lcsc.com/images/lcsc/900x900/20230201_Vishay-Intertech-SS3P6L-M3-86A_C968580_front.jpg | 2.2552 |  |  | ["D1"] |  |  |  | {"method": "buy", "scope": "finished_device"}
thermal_adc | ADS1115IDGSR |  | 1 | research | ADS1115IDGSR,3.3V I2C four-input ADC: AIN0 COB NTC,AIN1 shell NTC,AIN2 battery NTC,AIN3 divided protected battery. ADDR ground gives0x48;100nF bypass,4.7k I2C pull-ups. Uses explicitly remapped XIAO D7/GPIO20 SDA and D6/GPIO21 SCL; default I2C GPIO6/7 already drive loads. Datasheet pp3-5,11,23. | 18b591faf1133c74 | TI(德州仪器) | ADS1115IDGSR | ADS1115IDGSR | C37593 | LCSC | 11740 | https://item.szlcsc.com/38573.html | https://datasheet.lcsc.com/datasheet/pdf/ab99f5e86cc44c5b8c94f5d72223386b.pdf?productCode=C37593 | VSSOP-10 | extended | {"population": "mounted", "method": "manual"} | No approved drop-in alternate. Preserve exact MPN; recheck LCSC stock at purchase. Extended or unknown library is acceptable here because assembly is commissioned/manual, not a JLC SMT placement order. | https://assets.lcsc.com/images/lcsc/900x900/20190612_Texas-Instruments-ADS1115IDGSR_C37593_front.jpg | 7.83 |  |  | ["U3"] |  |  |  | {"method": "buy", "scope": "finished_device"}
thermal_probes | HNTC-103F3950FB-100P |  | 3 | research | HNTC-103F3950FB-100P finished epoxy-bead probe,10kohm1%,B25/50=3950K1%,100+/-5mm overall length INCLUDING bead,not free lead length,head max2.8x7.5mm. Typical tau<=15s in liquid; installed thermal lag must be checked. Remote sensors on COB,opaque-shell hot spot and battery. Datasheet pp1,3. Wire gauge is unspecified; do not crimp unknown probe wire directly into22-26AWG terminal. Commission a26AWG terminated adapter with staggered insulated splices. | dd183359c4d6908c | R+O(宏嘉诚) | HNTC-103F3950FB-100P | HNTC-103F3950FB-100P | C52204608 | LCSC | 949 | https://item.szlcsc.com/55044715.html | https://datasheet.lcsc.com/datasheet/pdf/75da80b46760b313f2ff79b66d32b944.pdf?productCode=C52204608 | - | unknown | {"population": "not_mounted", "method": "module_mount"} | No approved drop-in alternate. Preserve exact MPN; recheck LCSC stock at purchase. Extended or unknown library is acceptable here because assembly is commissioned/manual, not a JLC SMT placement order. | https://assets.lcsc.com/images/lcsc/900x900/20260603_R-O-HNTC-103F3950FB-100P_C52204608_front.jpg | 1.3679 |  |  |  |  |  |  | {"method": "buy", "scope": "finished_device"}
battery_protection_ic | BQ29700DSER |  | 1 | research | BQ29700DSER1S protector:OVP4.275V,UVP2.8V,OCD100mV20ms,SCD500mV250us nominal. Common-drain back-to-back low-side FET application with330ohm BAT filter,100nF,2.2kohm V-minus resistor,5Mohm gate-source bleeds. All loads and XIAO charging connect to PACK side,never bypass CELL-minus. Datasheet pp4-8,21-22. | 987c0d4d5dd22bf6 | TI(德州仪器) | BQ29700DSER | BQ29700DSER | C183096 | LCSC | 2956 | https://item.szlcsc.com/194498.html | https://datasheet.lcsc.com/datasheet/pdf/2eb82e7000dd0ebafe2a37c842a90ea8.pdf?productCode=C183096 | WSON-6(1.5x1.5) | extended | {"population": "mounted", "method": "manual"} | No approved drop-in alternate. Preserve exact MPN; recheck LCSC stock at purchase. Extended or unknown library is acceptable here because assembly is commissioned/manual, not a JLC SMT placement order. | https://assets.lcsc.com/images/lcsc/900x900/20230111_Texas-Instruments-BQ29700DSER_C183096_front.jpg | 3.33 |  |  | ["U4"] |  |  |  | {"method": "buy", "scope": "finished_device"}
battery_protection_fets | CSD85301Q2 |  | 5 | research | Five paralleled back-to-back pairs using each CSD85301Q2 independent dual N-MOS;join drains externally,balanced copper. Rds each max39mohm atVgs2.5V,Tj25C;combined five-pair path max15.6mohm. One pair would trigger100mV protection too early at this load. Design bound1.5x hot Rds plus3mohm traces gives26.4mohm,85mV minimum OCD=>3.22A above2.63A load budget. Hot factor and sharing require prototype measurement; protector is not a calibrated current limiter. Datasheet pp1,3-4. | ea00a31b0eaeda79 | TI(德州仪器) | CSD85301Q2 | CSD85301Q2 | C544396 | LCSC | 104 | https://item.szlcsc.com/565047.html | https://www.ti.com/cn/lit/ds/symlink/csd85301q2.pdf | WSON-6(2x2) | extended | {"population": "mounted", "method": "manual"} | No approved drop-in alternate. Preserve exact MPN; recheck LCSC stock at purchase. Extended or unknown library is acceptable here because assembly is commissioned/manual, not a JLC SMT placement order. | https://assets.lcsc.com/images/lcsc/900x900/20230204_Texas-Instruments-CSD85301Q2_C544396_front.jpg | 1.9045 |  |  | ["Q3", "Q4", "Q5", "Q6", "Q7"] |  |  |  | {"method": "buy", "scope": "finished_device"}
battery_fuse | 0451004.MRL |  | 1 | research | Littelfuse0451004.MRL,4A125V very-fast fuse,2410;series raw cell positive at battery entry. Datasheet p2 givesRnom16mohm andI2t3.152A2s;catalogI2t0.0551 is inconsistent and NOT used. Secondary fault protection,not a4A constant-current limiter. Startup inrush/temperature coordination must be tested. | 942b5d8d4a9f1193 | Littelfuse(美国力特) | 0451004.MRL | 0451004.MRL | C27515 | LCSC | 2354 | https://item.szlcsc.com/28264.html | https://datasheet.lcsc.com/datasheet/pdf/00c9748756ca418792b5b22a2bd74996.pdf?productCode=C27515 | 2410 | extended | {"population": "mounted", "method": "manual"} | No approved drop-in alternate. Preserve exact MPN; recheck LCSC stock at purchase. Extended or unknown library is acceptable here because assembly is commissioned/manual, not a JLC SMT placement order. | https://assets.lcsc.com/images/lcsc/900x900/20260522_Littelfuse-0451004-MRL_C27515_front.jpg | 2.2802 |  |  | ["F1"] |  |  |  | {"method": "buy", "scope": "finished_device"}
led_sense_resistor | 0.75ohm1%1206 current-sense resistor,>=0.25W |  | 1 | default | Rsense Kelvin route,200mV nominal;nom266.67mA,bounds257.43..276.09mA including195..205mV FB and1%R;maxdissipation0.0566W. | df3f619804a92fdb |  |  |  |  |  |  |  |  |  |  | {"population": "mounted", "method": "manual"} |  |  |  |  |  | ["R11"] |  |  |  | {"method": "buy", "scope": "finished_device"}
led_freq_resistor | 176kohm1%0603 resistor |  | 1 | default | TPS61500 FREQ nominal600kHz;frequency tolerance not specified for this exact resistor in datasheet,480kHz used as sensitivity assumption,not guaranteed limit. | df3f619804a92fdb |  |  |  |  |  |  |  | https://datasheet.lcsc.com/datasheet/pdf/9766003e8b0d81036438896263c3df0e.pdf?productCode=C1554283 |  |  | {"population": "mounted", "method": "manual"} |  |  |  |  |  | ["R12"] |  |  |  | {"method": "buy", "scope": "finished_device"}
led_ovp_top | 158kohm1%0603 resistor |  | 1 | default | OVP upper resistor,Vnom20.6472V,min19.6527,max21.6729 including1%R and1.192..1.266V reference. | df3f619804a92fdb |  |  |  |  |  |  |  |  |  |  | {"population": "mounted", "method": "manual"} |  |  |  |  |  | ["R13"] |  |  |  | {"method": "buy", "scope": "finished_device"}
led_ovp_bottom | 10kohm1%0603 resistor |  | 1 | default | OVP lower resistor;above LED14..18V plus3%VF measurement bound andFB0.205V. | df3f619804a92fdb |  |  |  |  |  |  |  |  |  |  | {"population": "mounted", "method": "manual"} |  |  |  |  |  | ["R14"] |  |  |  | {"method": "buy", "scope": "finished_device"}
led_soft_start | 47nF X7R25V0603 capacitor |  | 1 | default | SS soft-start capacitor per TI guidance. | df3f619804a92fdb |  |  |  |  |  |  |  |  |  |  | {"population": "mounted", "method": "manual"} |  |  |  |  |  | ["C9"] |  |  |  | {"method": "buy", "scope": "finished_device"}
led_compensation | 470nF X7R16V0603 capacitor |  | 1 | default | COMP to ground;layout and loop response must be checked on new board. | df3f619804a92fdb |  |  |  |  |  |  |  |  |  |  | {"population": "mounted", "method": "manual"} |  |  |  |  |  | ["C10"] |  |  |  | {"method": "buy", "scope": "finished_device"}
led_dim_filter | 1uF X7R10V0805 capacitor |  | 1 | default | DIMC to ground selects analog dimming;5kHz EN input. Start with continuous HIGH>=50ms before reducing duty;datasheet minimum start PWM on-time is200us,not20us. | df3f619804a92fdb |  |  |  |  |  |  |  | https://datasheet.lcsc.com/datasheet/pdf/9766003e8b0d81036438896263c3df0e.pdf?productCode=C1554283 |  |  | {"population": "mounted", "method": "manual"} |  |  |  |  |  | ["C11"] |  |  |  | {"method": "buy", "scope": "finished_device"}
led_input_cap | 4.7uF X7R10V0805 capacitor |  | 1 | default | Local VIN/PGND bypass,effective>=3.3uF at4.2V;shared battery bulk capacitor remains. | df3f619804a92fdb |  |  |  |  |  |  |  |  |  |  | {"population": "mounted", "method": "manual"} |  |  |  |  |  | ["C12"] |  |  |  | {"method": "buy", "scope": "finished_device"}
led_output_caps | 2.2uF X7R50V1210 capacitor |  | 2 | default | 4.4uF nominal total,require>=2.2uF combined at21.7V from chosen supplier DC-bias curve;1..10uF effective output range. | df3f619804a92fdb |  |  |  |  |  |  |  |  |  |  | {"population": "mounted", "method": "manual"} |  |  |  |  |  | ["C13", "C14"] |  |  |  | {"method": "buy", "scope": "finished_device"}
led_bleeder | 1Mohm1%0603 resistor |  | 1 | default | Across boosted output to discharge capacitance;do not hot-plug COB at charged output. | df3f619804a92fdb |  |  |  |  |  |  |  |  |  |  | {"population": "mounted", "method": "manual"} |  |  |  |  |  | ["R15"] |  |  |  | {"method": "buy", "scope": "finished_device"}
temperature_pullups | 10kohm0.1%0603 resistor |  | 3 | default | 3.3V to each NTC node,NTC toPACK_GND;maxNTC selfheat0.273mW at3.3V. | df3f619804a92fdb |  |  |  |  |  |  |  |  |  |  | {"population": "mounted", "method": "manual"} |  |  |  |  |  | ["R20", "R22", "R24"] |  |  |  | {"method": "buy", "scope": "finished_device"}
temperature_input_filter | 1kohm1%0603 resistor |  | 4 | default | Series ADC input resistors;separate analogue returns from switching ground. | df3f619804a92fdb |  |  |  |  |  |  |  |  |  |  | {"population": "mounted", "method": "manual"} |  |  |  |  |  | ["R21", "R23", "R25", "R28"] |  |  |  | {"method": "buy", "scope": "finished_device"}
temperature_filter_caps | 100nF X7R16V0603 capacitor |  | 4 | default | One per ADC input;NTC settling and multiplexer timing handled in firmware. | df3f619804a92fdb |  |  |  |  |  |  |  |  |  |  | {"population": "mounted", "method": "manual"} |  |  |  |  |  | ["C17", "C18", "C19", "C20"] |  |  |  | {"method": "buy", "scope": "finished_device"}
i2c_pullups | 4.7kohm1%0603 resistor |  | 2 | default | SDA/SCL pull-ups to3.3V,100kHz internal bus. | df3f619804a92fdb |  |  |  |  |  |  |  |  |  |  | {"population": "mounted", "method": "manual"} |  |  |  |  |  | ["R29", "R30"] |  |  |  | {"method": "buy", "scope": "finished_device"}
battery_adc_top | 100kohm1%0603 resistor |  | 1 | default | Protected battery toAIN3 divider top. | df3f619804a92fdb |  |  |  |  |  |  |  |  |  |  | {"population": "mounted", "method": "manual"} |  |  |  |  |  | ["R26"] |  |  |  | {"method": "buy", "scope": "finished_device"}
battery_adc_bottom | 100kohm1%0603 resistor |  | 1 | default | AIN3 divider bottom,2.1V nominal at4.2V battery. | df3f619804a92fdb |  |  |  |  |  |  |  |  |  |  | {"population": "mounted", "method": "manual"} |  |  |  |  |  | ["R27"] |  |  |  | {"method": "buy", "scope": "finished_device"}
protection_bat_filter | 330ohm1%0603 resistor |  | 1 | default | BQ29700 BAT input filter. | df3f619804a92fdb |  |  |  |  |  |  |  |  |  |  | {"population": "mounted", "method": "manual"} |  |  |  |  |  | ["R16"] |  |  |  | {"method": "buy", "scope": "finished_device"}
protection_vminus | 2.2kohm1%0603 resistor |  | 1 | default | PACK-minus toBQ29700 V-minus. | df3f619804a92fdb |  |  |  |  |  |  |  |  |  |  | {"population": "mounted", "method": "manual"} |  |  |  |  |  | ["R17"] |  |  |  | {"method": "buy", "scope": "finished_device"}
protection_gate_bleeds | 5.1Mohm1%0603 resistor |  | 2 | default | Shared CHG/DSG gate-to-source bleed resistors,close to paired FET bank. | df3f619804a92fdb |  |  |  |  |  |  |  |  |  |  | {"population": "mounted", "method": "manual"} |  |  |  |  |  | ["R18", "R19"] |  |  |  | {"method": "buy", "scope": "finished_device"}
added_bypass | 100nF X7R16V0603 capacitor |  | 2 | default | One BQ29700 BAT-VSS,one ADS1115 VDD-GND. | df3f619804a92fdb |  |  |  |  |  |  |  |  |  |  | {"population": "mounted", "method": "manual"} |  |  |  |  |  | ["C15", "C16"] |  |  |  | {"method": "buy", "scope": "finished_device"}
thermal_header | 1x03 2.54mm vertical pin header,2.54mm body,6mm mating pin |  | 1 | default | Internal extension forXIAO3V3,D7 SDA,D6 SCL;not an exterior port. | df3f619804a92fdb |  |  |  |  |  |  |  |  |  |  | {"population": "mounted", "method": "manual"} |  |  |  |  |  | ["J8"] |  |  |  | {"method": "buy", "scope": "finished_device"}
probe_headers | 1x02 2.54mm vertical pin header,2.54mm body,6mm mating pin |  | 3 | default | Three internal probe ports,NTC input plus ground;avoid swapped channels. | df3f619804a92fdb |  |  |  |  |  |  |  |  |  |  | {"population": "mounted", "method": "manual"} |  |  |  |  |  | ["J9", "J10", "J11"] |  |  |  | {"method": "buy", "scope": "finished_device"}
probe_female_housings | TE Connectivity 1375820-2 CST-100 II 2-position housing,2.54mm |  | 3 | research | TE supplier drawing p1: housing2P A5.59+0.25/-0.13mm,12.95mm axial length,6.60mm max cross section,pitch2.54mm;accepts1375819 family. J10/J11 rotated90degrees,row alongX,centreX13.35;conservative installed/service reserve6.5x9x20mm includes14mm plug and6mm bend allowance. 3 probes labelled COB/SHELL/BAT. Supplier drawing envelope,not a supplier STEP model. | 18bfd25a90ea331e | TE Connectivity(泰科电子) | 1375820-2 | 1375820-2 | C457186 | LCSC |  | https://item.szlcsc.com/460395.html | https://datasheet.lcsc.com/datasheet/pdf/2152979cf067360e65f60e8071bbc3ab.pdf?productCode=C457186 |  |  |  | No substitute larger housing accepted without fit check. Supplied as commissioned terminated pigtail; mating pin force still requires physical trial. |  |  |  |  |  |  |  |  | {"method": "buy", "scope": "finished_device"}
battery_spot_weld_service | Supplier spot-weld service:18650 nickel tabs,24AWG insulated leads and positive insulating ring |  | 1 | default | Exact bare cell with nickel tabs,positive insulating ring,24AWG red/black leads supplied by battery service;cut stock125/165mm,trim on routing jig. Wrapped cell reserveØ19x66.2mm;do not solder directly to cell. | df3f619804a92fdb |  |  |  |  |  |  |  |  |  |  |  |  |  |  |  |  |  |  |  |  | {"method": "buy", "scope": "finished_device"}
internal_reflector | One-piece matte-white ASA reflector with integral left/right COB supports |  | 1 | default | Single connected ASA print combines reflector and two supports,retains original M1.6 mounting joints and screw positions;two bonded interfaces removed. Remove collector first,then withdraw entire insert through nose. | df3f619804a92fdb |  |  |  |  |  |  |  |  |  |  |  |  |  |  |  |  |  |  |  |  | {"method": "print", "design_id": "helicopter", "object_ids": ["optical_reflector"], "material": "ASA", "colour": "哑白", "scope": "finished_device"}
protected_battery_header | 1x02 2.54mm vertical power header,rated>=3A,2.54mm body,6mm mating pins |  | 1 | default | NewPACK+/-outputtoXIAOBAT+/BAT-;allXIAOgroundsPACK-side. Do not reuse raw-cell negative as ground. | df3f619804a92fdb |  |  |  |  |  |  |  |  |  |  | {"population": "mounted", "method": "manual"} |  |  |  |  |  | ["J12"] |  |  |  | {"method": "buy", "scope": "finished_device"}
led_bias_link | 0ohm0603 resistor |  | 1 | default | R31 populated0ohm0603 separates the TPS61500 VIN-bias/C3 branch from the 3A inductor feeder. | df3f619804a92fdb |  |  |  |  |  |  |  |  |  |  | {"population": "mounted", "method": "manual"} |  |  |  |  |  | ["R31"] |  |  |  | {"method": "buy", "scope": "finished_device"}
protection_vss_link | 0ohm0603 resistor |  | 1 | default | R32 populated0ohm0603 forms Kelvin raw-cell-negative reference for U4 VSS,C15 bypass andR19 discharge gate bleed; not a load return. | df3f619804a92fdb |  |  |  |  |  |  |  |  |  |  | {"population": "mounted", "method": "manual"} |  |  |  |  |  | ["R32"] |  |  |  | {"method": "buy", "scope": "finished_device"}
probe_crimp_contacts | TE Connectivity 1375819-1 CST-100 II female crimp contact,22-26AWG |  | 6 | research | Exact1375820 housing contact family;datasheet p1:22-26AWG,insulationOD0.89-1.65mm. Crimp only onto specified26AWG adapter wire,not unspecified factory probe lead. | 52e6783f7279b313 | TE Connectivity(泰科电子) | 1375819-1 | 1375819-1 | C86473 | LCSC |  | https://item.szlcsc.com/87650.html | https://datasheet.lcsc.com/datasheet/pdf/a26ea52adfaa35c6b4be41ca745dba3e.pdf?productCode=C86473 |  |  |  | No substitute terminal without mechanical review. Order as a terminated pigtail to avoid crimp-tool minimum-order cost. |  |  |  |  |  |  |  |  | {"method": "buy", "scope": "finished_device"}
ntc_guide_ties | PA66 cable ties 2.5x100mm,temperature rating>=85C |  | 2 | default | Two2.5x100 ties:one softly anchors H10 alongside+Y motor post,one closes existing lower guide for H11. New H01 guide tie is separately listed. | df3f619804a92fdb |  |  |  |  |  |  |  |  |  |  |  |  |  |  |  |  |  |  |  |  | {"method": "buy", "scope": "finished_device"}
battery_cradle_print | PETG removable battery end gate for integral chassis |  | 1 | default | Only the removable end gate is printed separately;cradle belongs to the unit chassis. Preserve two M2 gate screws and terminal/cushion clearances. | df3f619804a92fdb |  |  |  |  |  |  |  |  |  |  |  |  |  |  |  |  |  |  |  |  | {"method": "print", "design_id": "helicopter", "object_ids": ["battery_gate"], "material": "PETG", "colour": "白", "scope": "finished_device"}
battery_gate_screws | M2x6mm ISO4762 stainless steel socket-head cap screw |  | 2 | default | Kit-generated recessed joints atX=+/-11.3,Y=24,Z=-8mm. Self-forming PETG pilot holes;no metal tapping of the printed part. | df3f619804a92fdb |  |  |  |  |  |  |  |  |  |  |  |  |  |  |  |  |  |  |  |  | {"method": "buy", "scope": "finished_device"}
battery_end_spacers | Silicone foam cushions,7x3x3mm stock,compressed to2.3mm |  | 2 | default | Axial buffers between cell end faces and end stops atY=+/-36.4,Z=-21mm. Keep terminal centre and spot-welded lead exits clear. | df3f619804a92fdb |  |  |  |  |  |  |  |  |  |  |  |  |  |  |  |  |  |  |  |  | {"method": "buy", "scope": "finished_device"}
noncuring_thermal_filler | Electrically insulating non-curing thermal filler,k>=3W/mK,0.1mm installed gaps |  | 1 | default | Only thin electrically insulating shell-contact interfaces;no filler interfaces within monolithic thermal bridge. | df3f619804a92fdb |  |  |  |  |  |  |  |  |  |  |  |  |  |  |  |  |  |  |  |  | {"method": "buy", "scope": "finished_device"}
probe_retention_tape | 10mm polyimide electrical-insulation tape,<=0.06mm thick |  | 1 | default | Hold battery NTC over a thin non-curing thermal layer so it can be removed without stripping the cell sleeve. COB and shell probes use insulating thermal adhesive away from solder pads and emitting area. | df3f619804a92fdb |  |  |  |  |  |  |  |  |  |  |  |  |  |  |  |  |  |  |  |  | {"method": "buy", "scope": "finished_device"}
hex_key_1p5 | Wera950 PKLS L-key,metric,chrome plated,1.5x90mm (05022040001) |  | 1 | default | Manufacturer90/4.5mm arms,Wera05022040001. Tool geometry checks include5mm threaded withdrawal,60degree re-indexing,key disengagement and ordinary hand seating/removal of freed screws. Shaft envelope1.8mm,bend envelope4.5mm are conservative engineering defaults;actual fit/torque not measured. | 9e326b3cebec3f63 | Wera | 05022040001 |  |  |  |  | https://www.wera.de/en/05022040001 | https://hybris-media.wera.de/download/pdfgenerator-datasheets/en/05022040001.pdf |  |  |  |  |  |  | https://hybris-media.wera.de/download/pdfgenerator-datasheets/en/05022040001.pdf |  |  |  |  | {"across_flats_mm": 1.5, "long_arm_mm": 90, "short_arm_mm": 4.5, "source": "manufacturer"} | {"method": "buy", "scope": "tool"}
female_housing_3 | 2.54mm1x03 narrow female crimp housing,maximum8.1x3x14mm |  | 1 | default | J8;3matching contacts included in24 loose contacts;0.64mm square mating pins. | df3f619804a92fdb |  |  |  |  |  |  |  |  |  |  |  |  |  |  |  |  |  |  |  |  | {"method": "buy", "scope": "finished_device"}
key_low_profile_sockets | 2.54mm1x02 low-profile solder-wire female socket,body<=8.5mm,total depth<=11.5mm |  | 2 | default | Custom harness termination specification;cross section<=3x5.6mm including insulation,contacts included. No extra PCB. Window ends only;fit actual0.64mm pins. Self-made soldered and heat-shrunk terminations must remain inside total envelope. Physical sample inspection required. | df3f619804a92fdb |  |  |  |  |  |  |  |  |  |  |  |  |  |  |  |  |  |  |  |  | {"method": "buy", "scope": "finished_device"}
controller_guide_tie | PA66 cable tie2.5x100mm,temperature rating>=85C |  | 1 | default | Closes new H01 open guide. Release or replace for deep service;do not compress wire insulation. | df3f619804a92fdb |  |  |  |  |  |  |  |  |  |  |  |  |  |  |  |  |  |  |  |  | {"method": "buy", "scope": "finished_device"}
