Cailynoo7/makit-project-6/product/print-list.csv

design_id | object_id | bom_id | name | quantity | material | colour | assembled_bbox_mm | scope
helicopter | fuselage | fuselage_lower_print | 固定侧机壳（负Y半壳） | 1 | PETG | 天蓝 | [89.65, 53.118, 84.449] | finished_device
helicopter | fuselage_cap | fuselage_cap_print | 可拆侧机壳（正Y半壳） | 1 | PETG | 天蓝 | [89.65, 45.118, 84.449] | finished_device
helicopter | internal_carrier | internal_carrier_print | 单一内架，含电池鞍座、控制板承托及导线槽 | 1 | PETG | 白 | [72.27, 69.4, 62.7] | finished_device
helicopter | battery_gate | battery_cradle_print | 可拆电池端挡 | 1 | PETG | 白 | [36.2, 10.9, 14.7] | finished_device
helicopter | tail | tail_print | 一体尾梁与尾翼 | 1 | PETG | 天蓝 | [138.024, 35.638, 50.048] | finished_device
helicopter | main_rotor | main_rotor_print | 一体主旋翼 | 1 | PETG | 白 | [250.0, 250.0, 32.256] | finished_device
helicopter | tail_propeller | tail_prop_print | 装饰尾桨 | 1 | PETG | 白 | [35.571, 7.688, 31.735] | finished_device
helicopter | skid_left | skid_print | 左右起落架，分别打印 | 1 | PETG | 白 | [93.75, 30.325, 31.625] | finished_device
helicopter | skid_right | skid_print | 左右起落架，分别打印 | 1 | PETG | 白 | [93.75, 30.325, 31.625] | finished_device
helicopter | window_left | fixed_windows | 左右不透明浅蓝窗面 | 1 | PETG | 浅蓝 | [42.6, 15.608, 42.6] | finished_device
helicopter | window_right | fixed_windows | 左右不透明浅蓝窗面 | 1 | PETG | 浅蓝 | [42.6, 15.608, 42.6] | finished_device
helicopter | button_left | button_caps | 灯与风扇按钮，分别打印 | 1 | PETG | 浅蓝 | [14.0, 7.8, 14.0] | finished_device
helicopter | button_right | button_caps | 灯与风扇按钮，分别打印 | 1 | PETG | 浅蓝 | [14.0, 7.788, 14.0] | finished_device
helicopter | window_bezel_left | window_bezel_left_print | 左窗装饰外框 | 1 | PETG | 白 | [43.75, 2.384, 43.75] | finished_device
helicopter | window_bezel_right | window_bezel_right_print | 右窗装饰外框 | 1 | PETG | 白 | [43.75, 2.384, 43.75] | finished_device
helicopter | window_retainer_left | window_retainer_print | 左右窗内压环，分别打印 | 1 | PETG | 白 | [52.0, 12.121, 28.0] | finished_device
helicopter | window_retainer_right | window_retainer_print | 左右窗内压环，分别打印 | 1 | PETG | 白 | [52.0, 12.121, 28.0] | finished_device
helicopter | skid_clamps_left | skid_root_caps_print | 四处起落架根部曲面压帽 | 1 | PETG | 白 | [9.2, 13.22, 9.2] | finished_device
helicopter | skid_clamp_right_aft | skid_root_caps_print | 四处起落架根部曲面压帽 | 1 | PETG | 白 | [9.2, 13.22, 9.2] | finished_device
helicopter | skid_clamps_right | skid_root_caps_print | 四处起落架根部曲面压帽 | 1 | PETG | 白 | [9.2, 13.22, 9.2] | finished_device
helicopter | skid_clamp_left_aft | skid_root_caps_print | 四处起落架根部曲面压帽 | 1 | PETG | 白 | [9.2, 13.22, 9.2] | finished_device
helicopter | bearing_pedestal | rotor_fixed_axle_print | 固定轴与轴承内圈承重支座 | 1 | PETG | 白 | [12.6, 12.6, 25.8] | finished_device
helicopter | rotor_bearing_spacer | rotor_bearing_spacer_print | 轴承外圈隔套 | 1 | PETG | 白 | [19.0, 19.0, 7.9] | finished_device
helicopter | rotor_inner_spacer | rotor_inner_spacer_print | 轴承内圈隔套 | 1 | PETG | 白 | [12.6, 12.6, 7.9] | finished_device
helicopter | hub_cover | hub_cover_print | 主旋翼轴承压盖 | 1 | PETG | 白 | [32.5, 32.5, 6.95] | finished_device
helicopter | mast | mast_print | 固定吊杆 | 1 | PETG | 白 | [13.5, 13.5, 41.0] | finished_device
helicopter | magnet_base | magnet_base_print | 磁吸顶部座 | 1 | PETG | 白 | [45.43, 45.43, 13.75] | finished_device
helicopter | drive_pulley | drive_pulley_print | 电机D轴小带轮 | 1 | PETG | 白 | [9.8, 9.8, 4.0] | finished_device
helicopter | nose_lens | nose_diffuser | 前透光罩 | 1 | PETG | 半透明 | [9.563, 58.815, 58.815] | finished_device
helicopter | belly_lens | belly_diffuser | 底透光片 | 1 | PETG | 半透明 | [63.75, 63.75, 1.2] | finished_device
helicopter | optical_reflector | internal_reflector | 一体反光罩及左右光源支座 | 1 | ASA | 哑白 | [25.0, 46.0, 25.0] | finished_device
