Cailynoo7/makit-project-6/design/helicopter/source/assets/ac4d310f2952dc16322d9929defc3690d3976e8f80f76adf954dd4bd8da901af.step

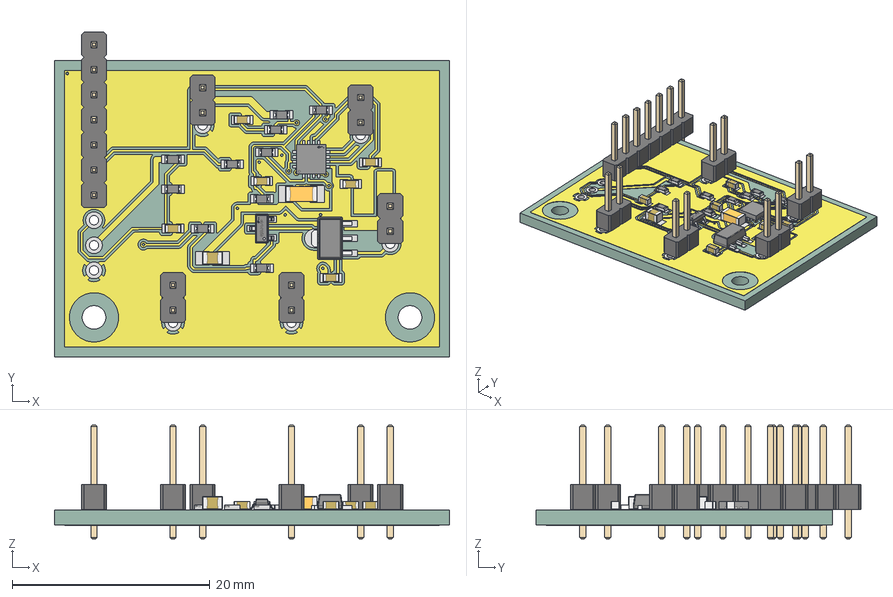
[picture p3: CAD file, 2026-11-13]
design/helicopter/source/assets/ac4d310f2952dc16322d9929defc3690d3976e8f80f76adf954dd4bd8da901af.step
40.0 x 32.9 x 11.5 mm
R0603 x 10
C0603_L1.6-W0.8-H0.8 x 6
PinHeader_1x02_P254mm_Vertical x 5
SOT-23-3P_L2.9-W1.3-H1.0-LS2.4-P0.95
C1206_L3.2-W1.6-H1.3
WQFN-16_L3.0-W3.0-P0.50-BL-EP1.7
SOT-89-3_L4.3-W2.5-H1.6-LS4.1-P1.50
C0805_L2.0-W1.3-H1.3
PinHeader_1x07_P254mm_Vertical
board_copper
board_pad
board_via
board_PCB
