Cailynoo7/makit-project-6/design/keys/source/models/kinghelm-kh-6x6x4p3h-drawing.step

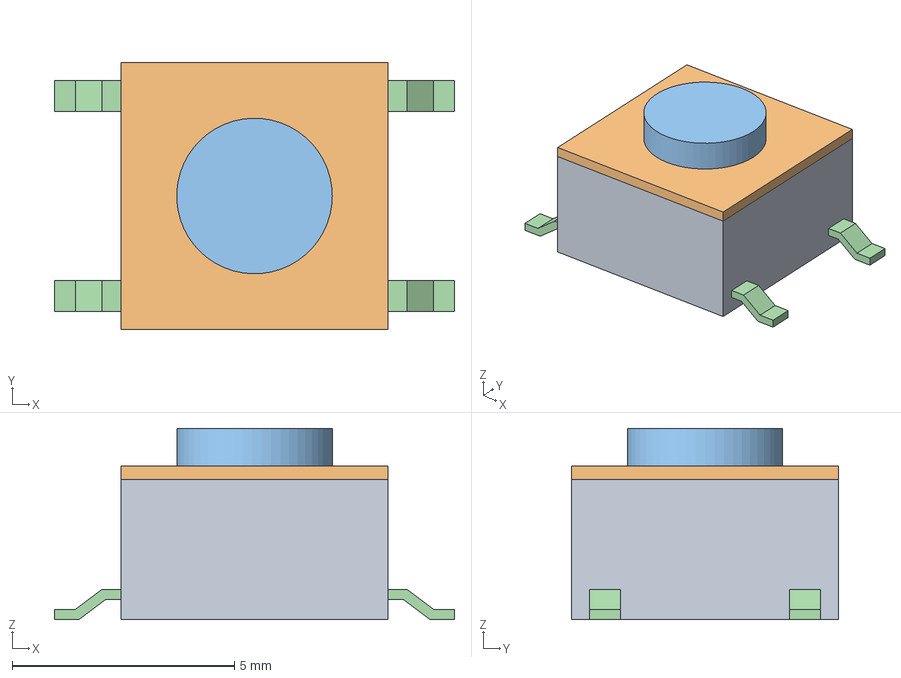
[picture p4: CAD file, 2026-11-13]
design/keys/source/models/kinghelm-kh-6x6x4p3h-drawing.step
9.00 x 6.00 x 4.30 mm
