Cailynoo7/makit-project-6/design/switch_reference/source/assets/4c64164c21ae9286e84e0b4873d2902ae02953202b7cdcb915145f316ab6aae3.step

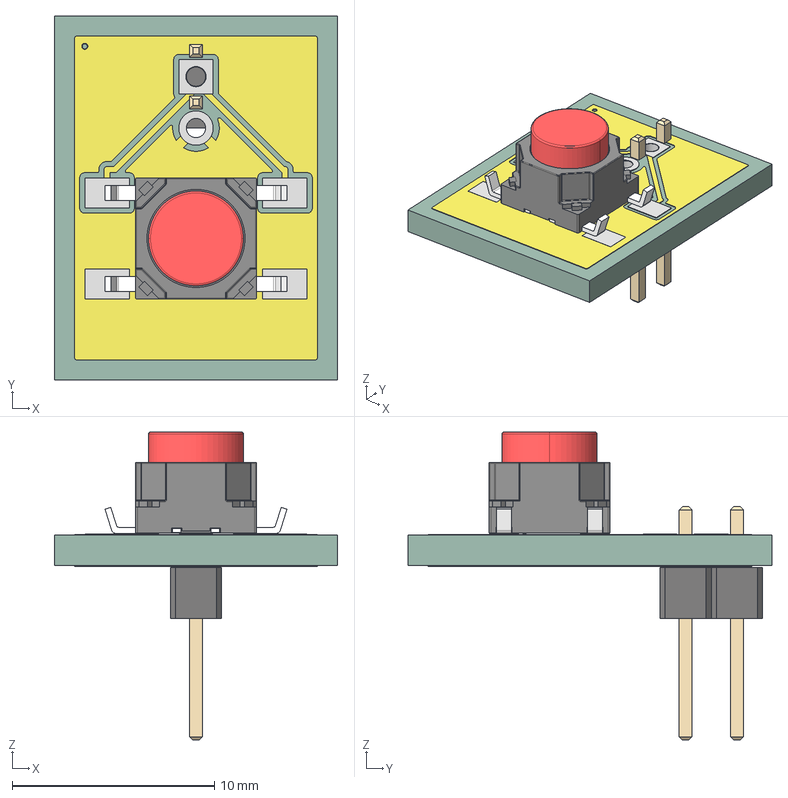
[picture p5: CAD file, 2026-11-13]
design/switch_reference/source/assets/4c64164c21ae9286e84e0b4873d2902ae02953202b7cdcb915145f316ab6aae3.step
14.0 x 18.0 x 15.2 mm
SW-SMD_4P-L6.0-W6.0-P4.50-LS9.0
PinHeader_1x02_P254mm_Vertical
board_copper
board_pad
board_via
board_PCB
