Cailynoo7/makit-project-6/design/helicopter/source/assets/203cec51bb3c7537266c230459960bd4a061e18f3619b9e0358805bf63a08652.step

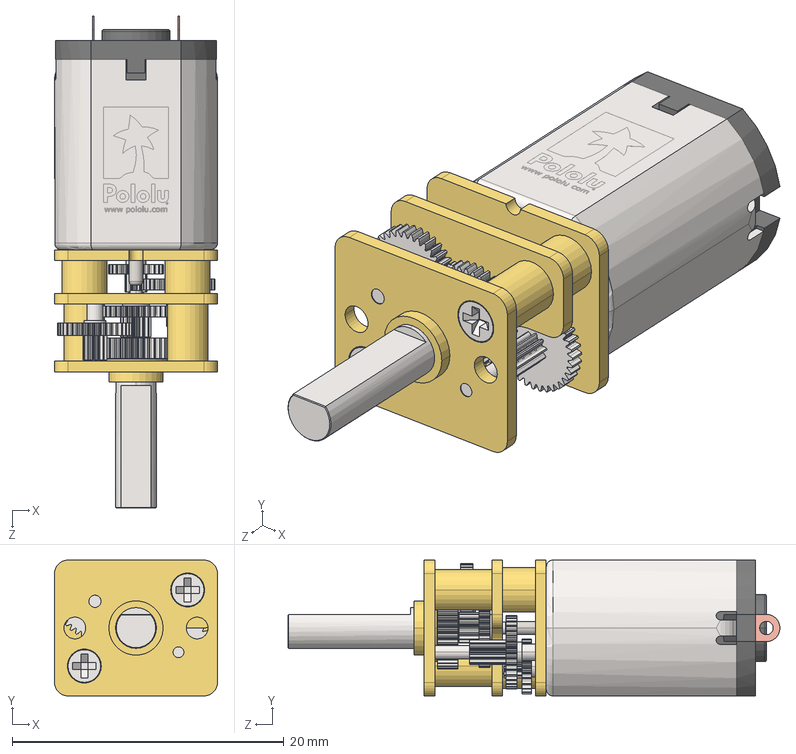
[picture p7: CAD file, 2026-11-13]
design/helicopter/source/assets/203cec51bb3c7537266c230459960bd4a061e18f3619b9e0358805bf63a08652.step
12.0 x 10.0 x 36.2 mm
