Cailynoo7/makit-project-6/design/connection/source/models/PinHeader_1x07_P2.54mm_Vertical.step

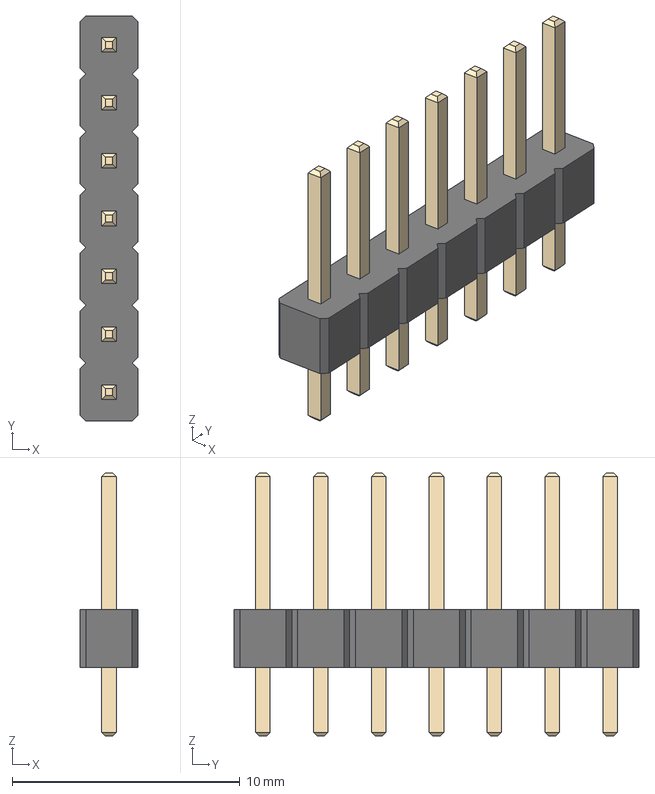
[picture p8: CAD file, 2026-11-13]
design/connection/source/models/PinHeader_1x07_P2.54mm_Vertical.step
2.54 x 17.8 x 11.5 mm
