Cailynoo7/makit-project-6/design/helicopter/source/assets/6cf33efeb8fe32725a1a155d6954e6ae308a159887b4417ea369cf881fb90549.step

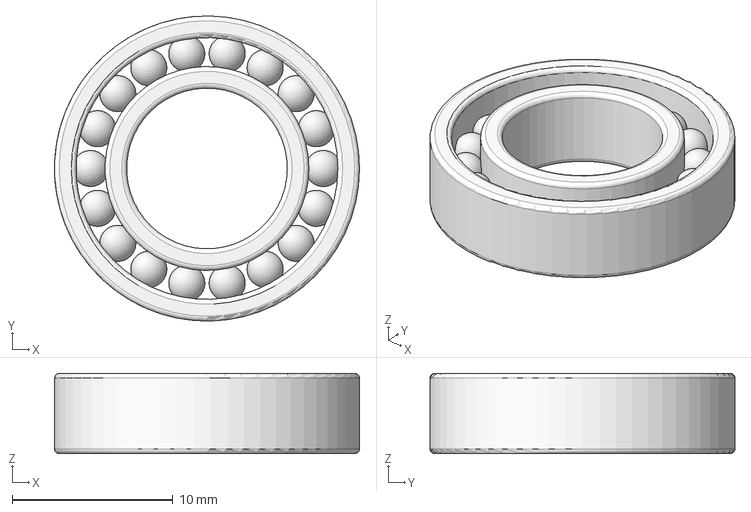
[picture p9: CAD file, 2026-11-13]
design/helicopter/source/assets/6cf33efeb8fe32725a1a155d6954e6ae308a159887b4417ea369cf881fb90549.step
19.0 x 19.0 x 5.00 mm
Roller x 18
