Cailynoo7/makit-project-6/design/helicopter/source/assets/fbfd4d668e9de8710b6d213edb7c358172732faa12a5a4a839ea3f99a853564c.step

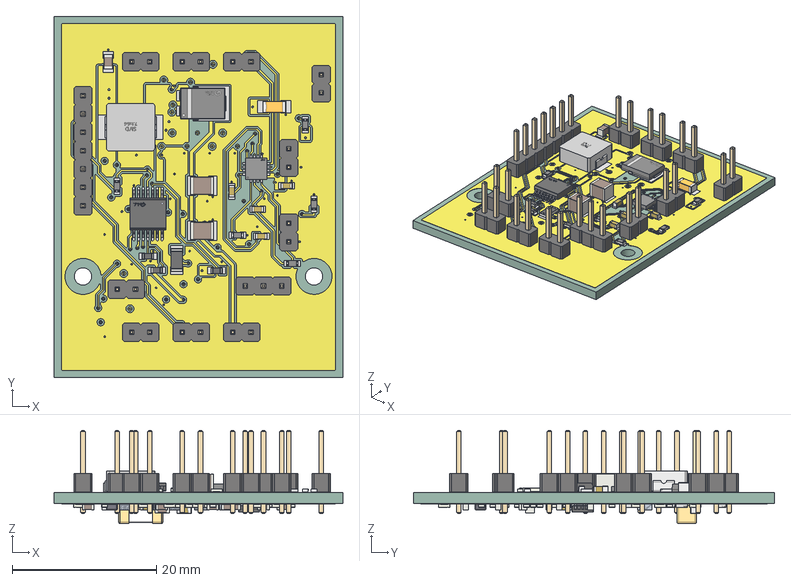
[picture p11: CAD file, 2026-11-13]
design/helicopter/source/assets/fbfd4d668e9de8710b6d213edb7c358172732faa12a5a4a839ea3f99a853564c.step
40.0 x 50.0 x 12.9 mm
R0603 x 10
PinHeader_1x02_P254mm_Vertical x 10
C0603_L1.6-W0.8-H0.8 x 6
R_0603_1608Metric x 21
R_1206_3216Metric
TO-277A_L6.1-W4.6-P2.13-LS6.5-TR
HTSSOP-14_L5.0-W4.4-P0.65-LS6.4-BL-EP-1
PinHeader_1x03_P254mm_Vertical
PinHeader_1x07_P254mm_Vertical
IND-SMD_L7.1-W6.6-H2.8
WQFN-16_L3.0-W3.0-P0.50-BL-EP1.7
C1206_L3.2-W1.6-H1.3
C_1210_3225Metric x 2
C_0805_2012Metric x 2
CSD85301Q2 supplier faceted model x 5
WSON-6_L1.5-W1.5-H0.8-P0.50-TL
C_0603_1608Metric x 8
MSOP-10_L3.0-W3.0-H1.1-LS5.0-P0.50
C0805_L2.0-W1.3-H1.3
FUSE-SMD_L6.1-W2.7-H2.7
board_copper
board_pad
board_via
board_PCB
