Cailynoo7/makit-project-6/design/helicopter/source/assets/993c6fc81ba7372f7678382a7cd355976283f7e46fec1ddac991f64a3b5cbec3.step

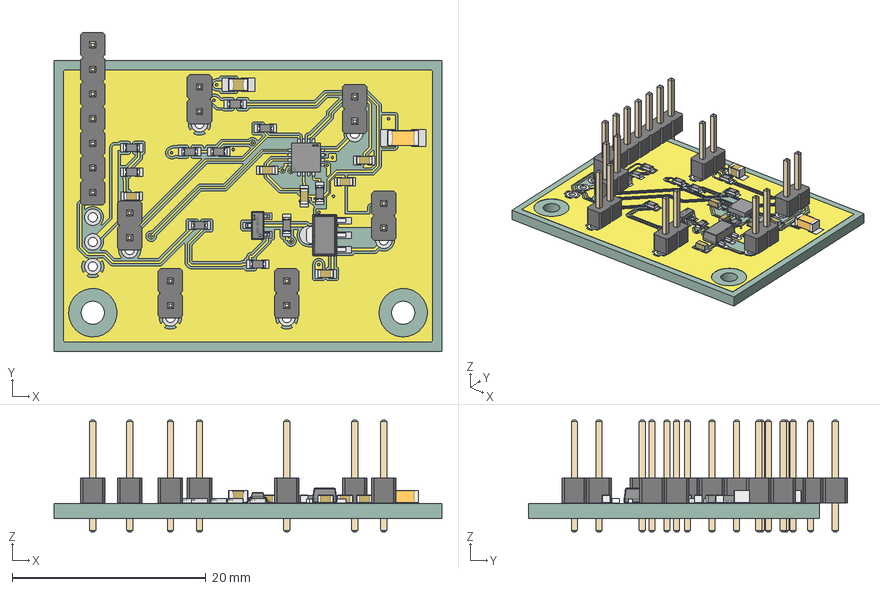
[picture p12: CAD file, 2026-11-13]
design/helicopter/source/assets/993c6fc81ba7372f7678382a7cd355976283f7e46fec1ddac991f64a3b5cbec3.step
40.0 x 32.9 x 11.5 mm
R0603 x 10
PinHeader_1x02_P254mm_Vertical x 6
C0603_L1.6-W0.8-H0.8 x 6
SOT-23-3P_L2.9-W1.3-H1.0-LS2.4-P0.95
SOT-89-3_L4.3-W2.5-H1.6-LS4.1-P1.50
C0805_L2.0-W1.3-H1.3
WQFN-16_L3.0-W3.0-P0.50-BL-EP1.7
PinHeader_1x07_P254mm_Vertical
C1206_L3.2-W1.6-H1.3
board_copper
board_pad
board_via
board_PCB
