Cailynoo7/makit-project-6/design/helicopter/source/assets/3b922791c27c8a41e3812bc7b78e72789767ffb378cc199997cc15294ea0fd2a.step

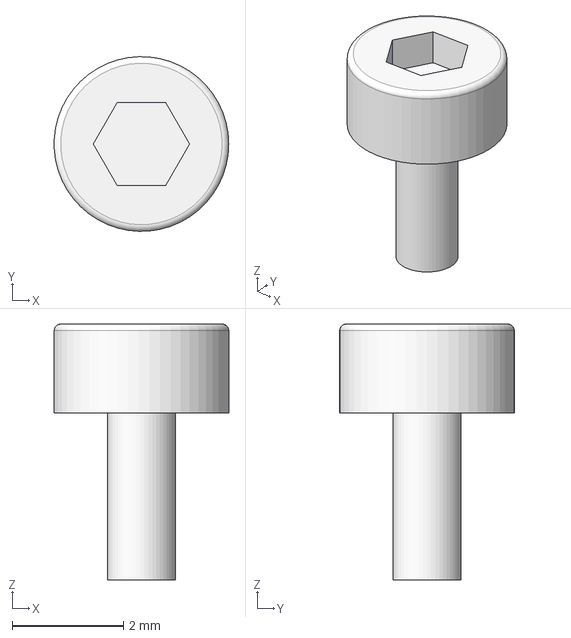
[picture p13: CAD file, 2026-11-13]
design/helicopter/source/assets/3b922791c27c8a41e3812bc7b78e72789767ffb378cc199997cc15294ea0fd2a.step
3.14 x 3.14 x 4.60 mm
