Cailynoo7/makit-project-6/design/helicopter/source/assets/25a187cee2fd6b966885ce825cd2f2b1daf1ff4ee3670edd3007ffb8a7f189af.step

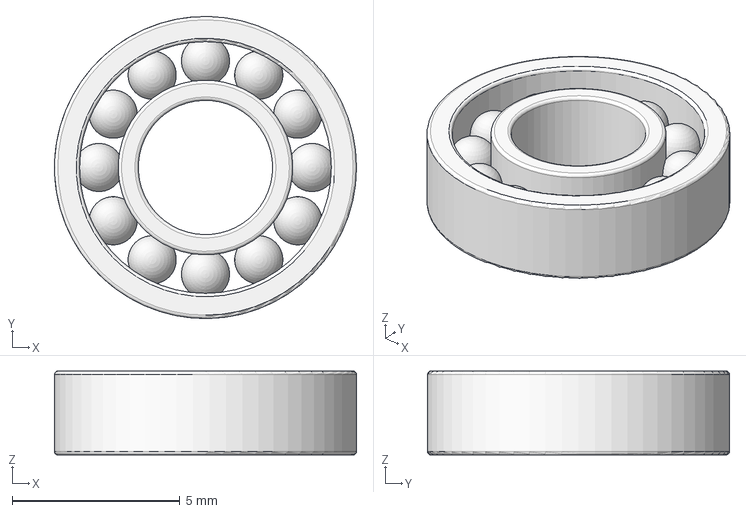
[picture p14: CAD file, 2026-11-13]
design/helicopter/source/assets/25a187cee2fd6b966885ce825cd2f2b1daf1ff4ee3670edd3007ffb8a7f189af.step
9.00 x 9.00 x 2.50 mm
Roller x 12
