Cailynoo7/makit-project-6/design/helicopter/source/assets/61bb522824f253e41ba5f03eeadca6c897be14ab9506143808c88acf5f8c076b.step

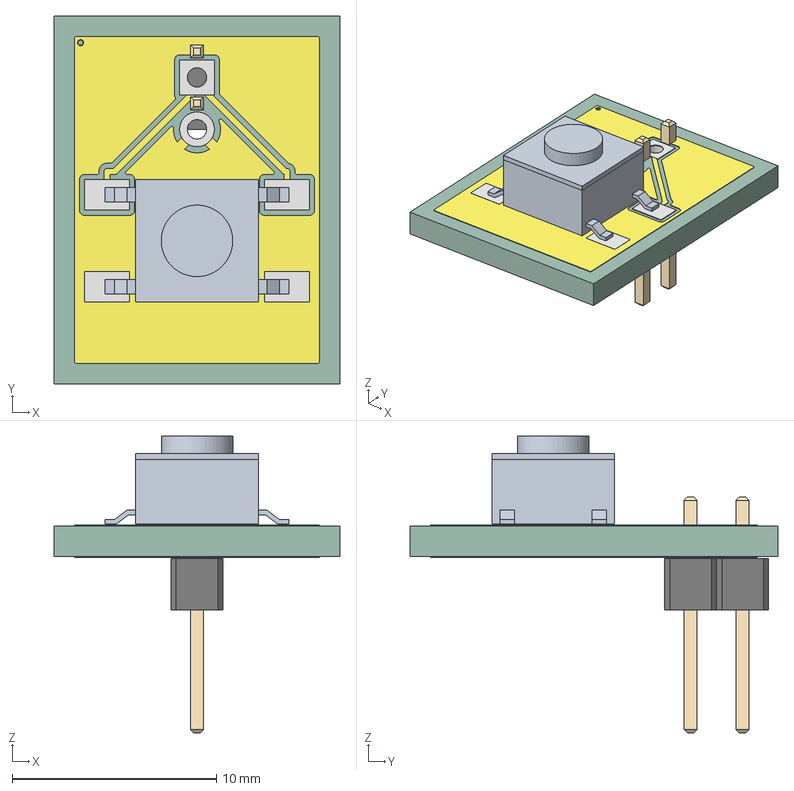
[picture p15: CAD file, 2026-11-13]
design/helicopter/source/assets/61bb522824f253e41ba5f03eeadca6c897be14ab9506143808c88acf5f8c076b.step
14.0 x 18.0 x 14.5 mm
switch
PinHeader_1x02_P254mm_Vertical
board_copper
board_pad
board_via
board_PCB
