Cailynoo7/makit-project-6/(list of files, cad)

Other CAD files:
design/charging_fit/source/assets/e4c01ebafa3f907ca3678744d574227cf68b36585daca3c78ca5afa4cba9fb98.step
design/helicopter/source/assets/4e0aa490b5d737619f6fee8720de3aa324388a98d51fd871130856d8007742a3.step
design/helicopter/source/assets/53c4aeef2c11a54b23d5a41e01719637dcb62eef1655663ac418c3d832bc0019.step
design/helicopter/source/assets/97b64f58d969325488c3e8c541e34b43c99c70e166c44fb888f1083cddb16f89.step
design/helicopter/source/assets/ed34eb03e927f6866d5bbc050583d91d288bcd12a09a49cda3c53fbb0bde3b60.step
design/helicopter/source/assets/fc23d823501f2122fb408aff5a5d877ccbb83121c4ce9a2b2c629d2c3c5ca9a0.step
design/connection/source/models/csd85301q2-supplier-faceted.step
design/connection/source/models/tps61500pwp-supplier.step
design/helicopter/source/assets/4654e142e46567c1d5b3a369d0c9be4d100c70c75d63b8a40d4c83222489d82d.step
