Cailynoo7/makit-project-6/product/内部光学与装配评审.md

> 历史检查范围：本文原有路径与分散导热件只对应文内旧版本。当前左右分壳、单一内架、一体热桥以结构重构评审和新版本检查记录为准；旧路径不作为当前装配通过证据。

# 内部光学、完整布线和铝加工评审

2026-11-13，当前机身47a887e8。相对此前c26095d，新增反光罩、线束参考和线束夹；仅修改XIAO卡座隐藏焊线槽与左右铝桥出线槽。机壳、前底透光件、圆窗/白框/12mm按钮、旋翼、尾部、起落架及配色的几何均不变。机头到尾端244.660mm，旋翼250mm。

## 光路

COB仍朝下。白色哑面ASA反光罩壁1.6，上口Z=-4、下口Z=-25.5，前侧内部16×2混光口及25°遮光片，前透光片接收间接柔光，主光通过原底部透光片。下口至底片内表面名义约9.55mm，保留混光空间；没有改变两个透光孔大小。

4条选取的COB中心至底片采样线无遮挡，仅证明这些几何通道存在。白ASA反射率、打印透光率、前口分光比例和多次反射损失均未测，因此不把目录620lm、预算260lm或4条光线当作整灯照度。实际底片、前片及白罩必须一起做热稳定照度网格与直视眩光检查；Ra/色温不因使用白罩自动获得额外认证。

反光罩与两只ASA支座为一体打印件，不直接钩住球壳，取消两处薄胶连接。拆COB及支座螺钉后，从前口整体取出；保留原支座孔位和集热板连接。

## 电池、接线与散热

3200mAh电芯独立托座、单条25mm宽绑带、端挡和防滑定位保留；XIAO下方卡座增加3处R1焊线避让，USB开口中心未变。局部试件与整机卡座体积均为622.533137mm³，三处槽同步；实板/焊线/USB插合仍要做试件。

H01–H12全部落到接口、焊盘或探头末端。两根RAW电芯线绕过PCB板边后下降；主束有12根独立导线和R6检修半圆。窗端插座缩为总深≤11.5mm低型焊线母座，普通主板母壳总高≤14mm。三只TE探头壳和24只普通触点加4只窗座自带触点的数量已分开。模型为采购包络，不冒充厂家STEP或线束电气连接。

铝件共15件、理论净重40.083g：18×34×3集热板、双桥、2上盖连接件、4可拆接触座、6片0.5mm内衬。左右桥增加R4开放出线槽，热接触面、孔位未改。六片内衬体积/厚度等效面积72.137cm²，不是外壳实际有效换热面积；旧180cm²概念及相应换热估算不得用于现版判合格。

COB胶层12×12×0.15、k≥1.5的一维理想热阻约0.694K/W，只描述这一胶层。多处0.1mm可拆热界面填k≥3非固化绝缘材料；接触座不永久胶死，上盖下搭接保持可分离。全部接触/壳壁/外界换热与局部热点共同决定持续功率，目前没有整条热阻实测值。

## 原版检查记录（简化后的变更处另复查）

最终104个物体共5356对静态检查无共享体积，未以“配合”掩盖硬穿透。21组分阶段刚性拆装路径含白罩/ASA组合和束线夹，最大点步长0.5mm、窗模块0.25mm，曲面网格公差0.02mm，无穿透；起始承靠面接触仍存在。最终完整束线至上盖的网格最小间隙约0.30mm，打印和布线公差很敏感，应先试装，不据名义值强行合盖。

12只主板插壳按0.5mm步长BRep拔出无相交；J9先上6.3、尾侧5、再上12，其他主板插壳上12。两只窗端插座在主板托架移出后，向中心6.3、再上12无相交。主板仍在位时不允许直接向中心硬拔窗端。所有路径均以断电、解除扎带/贴带并人工停放柔性支线为前提，不模拟软线自动跟随。

15页A3金属加工图由同版STEP投影，有三视图、虚线、等轴测和孔/螺纹；没有剖视/辅助视图，也不是球面片的平板展开图。剩余三维曲面和局部让位由同版STEP及中文加工说明定义。默认加工公差已写入产品要求，不宣称厂家已确认工艺或交期。

## 待首样验收

500lx平均、最低300lx、最大/最小≤3的30cm高40×30cm读写目标不变。必须在热稳定及温控降功率后仍满足，不能只看开机瞬时亮度。温度校准、封壳灯单开/灯扇同开、35℃环境敏感性、USB关闭两负载及故障模拟按既有首样步骤执行。程序不能关闭XIAO原充电电路。

旋翼实际风量、动平衡、绕组RMS电流≤0.375A、磁吸承载、噪声和续航仍未实测。固件现有35场景11329断言及XIAO目标编译结果保留，本次未修改程序，仅在接线表追加路由标识。采购数据沿用此前供应商证据，库存与报价未刷新；Pololu3060、M4×90及定制金属/线束需在下单时确认交期与样件。
