Cailynoo7/makit-project-6/product/线束装配与裁线表.md

# 整套线束装配与裁线

适用左右分壳、单一内架和一体热桥。逐针连接以接线表为准；路由是安装包络，不代表交汇线发生电气连接。

毛坯含总计8mm端接/修整余量并向上5mm取整；工装修到压接位，不在舱内额外盘线。H01扣除公共初始上升段后逐芯计入扇入和扇出；H07/H08计入共享主束余段。分支汇入不表示电气拼接。

|回路|起点|终点|线规|毛坯mm/根|
|---|---|---|---|---:|
|H01.1|J1.1|D1|26AWG|195|
|H01.2|J1.2|D2|26AWG|190|
|H01.3|J1.3|D3|26AWG|190|
|H01.4|J1.4|D4|26AWG|190|
|H01.5|J1.5|D10|26AWG|200|
|H01.6|J1.6|VBUS|26AWG|205|
|H01.7|J1.7|GND|24AWG|205|
|H02P|J2.1|CELL+|24AWG|125|
|H02N|J2.2|CELL-|24AWG|165|
|H03A|J3.1|MOTOR_A|24AWG|95|
|H03B|J3.2|MOTOR_B|24AWG|95|
|H04+|J4.1|COB+|26AWG|105|
|H04-|J4.2|COB-|26AWG|115|
|H05.1|J5.1|SW_L.J1.1|26AWG|70|
|H05.2|J5.2|SW_L.J1.2|26AWG|70|
|H06.1|J6.1|SW_R.J1.1|26AWG|40|
|H06.2|J6.2|SW_R.J1.2|26AWG|40|
|H07.1|J7.1|D5|26AWG|170|
|H07.2|J7.2|GND|26AWG|175|
|H08.1|J8.1|3V3|26AWG|160|
|H08.2|J8.2|D7 SDA|26AWG|160|
|H08.3|J8.3|D6 SCL|26AWG|150|
|H12.1|J12.1|BAT+|24AWG|130|
|H12.2|J12.2|BAT-|24AWG|130|

H09/H10/H11探头头至插壳毛坯总长125/80/105mm，包含探头和插壳，不额外加线。TE1375820-2配1375819-1触点及26AWG转接段；焊点错开至少8mm，逐根热缩，单处外径不超过1.8mm、合拢不超过3.4mm。24AWG绝缘外径不超过1.4mm，26AWG不超过1.1mm。普通母壳安装高不超过14mm；窗端低型焊线母座总深不超过11.5mm。不能拿普通长母壳替换窗端。

## 路由与固定

H01沿负Y侧绕电机后下降，在XIAO上方保留R6检修半圆；H02沿PCB外侧下降；H04/H09经前端合壳耳下方的内部让线槽，不能夹入螺钉。H10绑在原电机支柱旁，不再安装上部导向环。H11经一体下导向到电芯。H12沿后支柱内侧绕到XIAO底面焊盘。

F01：一体内架开放导向，孔R4、外缘R5.2、壁厚1.2；用一条2.5x100扎带关闭开口，无独立夹和胶接步骤。

F02：+Y电机支柱侧软绑1条扎带，在线束自然位置固定，不牵入皮带

F03：一体内架下导向+1条扎带；不勒探头根。

F04：电芯端挡内侧聚酰亚胺带应力释放；不得挡正极泄压口，不拉点焊片

F05：集热板非光面边缘绝缘胶带固定；前光腔用白色绝缘线/白套管，检修先揭带

F06：窗板后侧低型焊线母座，焊点逐根热缩；窗端插座待主托架移出后再拔

导向结构已并入内架，主束夹不再粘接。XIAO滑入后用一处可剥离绝缘胶带止退；不遮挡USB，不拉扯焊点。全部焊接、压接和标签由用户完成，没有厂家预装假设。

固定末端存在小于R6的定型弯，具体数值记录于路由数据；只定型一次，避开焊点和探头根反复弯折。实际线材能力、压接拉力、绝缘和插合必须实物检查。

## 装配与检修

先断USB/J2并取下前、底透光片；两颗锁壳螺钉分别从前口和底口卸出，再沿+Y开侧壳。整架取出前解除皮带和固定侧按键支线，松扎带/胶带并将柔性线停放到壳外；卸唯一内架螺钉后沿+Y取出。SHELL探头随热桥。

H12绕后下锁点外侧，沿新增充电板支架让线槽进入底面焊盘；不得跨过螺钉轴线或塞入内架退出通道。

主板及其插壳在壳外操作，柔性线束不得拖着作刚性组件运动。

逐线验收导通、极性及不同网无短接；RAW-不旁路到PACK-，LED_FB不接地，三只探头不互换。先断电再插拔升压光源。几何不穿透不等于通过电气、拉力、温升或线材耐久测试。
