Cailynoo7/makit-project-6/product/自行装配说明.md

# 自行制作与装配说明

从散件开始自行制作，不依赖厂家预装。先断电完成试装，再装透光片。

1. 在桌面放稳一体内架。内架包含电池鞍座、XIAO承托和线束导向；不另装支架或托座扎带。

2. 把XIAO滑入内架导轨。壳外从尾侧滑入；再用一处可剥离绝缘胶带作轴向止退，不挡USB、不拉焊点；不装独立卡座或卡座螺钉。

3. 贴后端电池缓冲垫。

4. 固定电芯温度探头。按电芯绝缘包覆固定，不在电芯上直接焊接。

5. 沿端部滑入带点焊引线的电池。断开电源；先穿入25mm宽绑带。

6. 束紧单条宽电池绑带。保留电芯绝缘层，不能让绑带压住焊点或探头。

7. 贴端挡缓冲垫。

8. 放上可拆电池端挡。端挡沿电池轴向推入，无需抬升、转向或拆主板/热桥。

9. 锁紧电池端挡两颗螺钉。两颗M2×6，逐颗拧紧。

10. 放入电机。

11. 锁紧电机两颗螺钉。

12. 装入电机小带轮。

13. 安放主电路板。热桥安装前，由机头侧平移到安装位置上方3mm，再下降落座；随后锁板。以本次路径检查为准。

14. 锁紧主板两颗螺钉。

15. 安放一体反光罩。

16. 锁紧反光罩两颗螺钉。

17. 把COB贴到一体金属热桥。壳外操作；保留电气绝缘导热胶层，等待规定固化时间。

18. 固定光源温度探头。

19. 固定热桥贴壳处温度探头。探头固定在热桥贴壳面的内侧，以电绝缘导热胶填实约0.3mm名义胶隙，不粘活动壳；通过实测校准与外壳热点的温差。

20. 锁紧热桥两颗安装螺钉。无需贴装独立均热片、接触座或桥根螺钉。

21. 铺设并连接线束。壳外逐线焊接或压接、绝缘并验证导通和极性；完整线束是包络参考，不打印。主束夹已并入内架，用一条扎带关闭开口。左右窗支线暂留余量。

22. 准备固定侧机壳。

23. 插入尾梁。

24. 锁紧尾梁唯一固定螺钉。

25. 装入装饰尾桨。

26. 装固定侧窗的按钮和外框。外框薄胶固定；按钮不得预压。

27. 装固定侧按键板与内压环。

28. 锁紧固定侧窗两颗螺钉。

29. 装固定侧起落架。

30. 锁住固定侧起落架前后根部。两处压帽与两颗M2×8；逐处锁紧。

31. 装轴承与主旋翼组件。此卡包含独立轴承装配、隔圈、旋翼、毂盖、吊杆和磁座安装以及M4承重螺栓锁紧；不能按一项手工动作计数。轴承胶只用于指定外圈/毂，胶不得进入滚道。先完成固定半壳的承重装配和M4锁紧，再装磁铁；此连接以后开侧壳不拆。

32. 将内架组件从侧面放入。先接固定侧窗支线；热桥贴壳面薄涂可拆绝缘导热材料，整架从+Y侧装入，前定位销就位。无需拆已经装好的吊杆和轴承。

33. 锁紧内架唯一固定螺钉。M2×6从直通操作通道进入；不要拆开电池或电机才能拧螺钉。

34. 套上驱动皮带。检查自由转动、预紧及旋翼平衡。

35. 准备可拆侧机壳。

36. 装可拆侧窗按钮和外框。

37. 装可拆侧按键板与内压环。

38. 锁紧可拆侧窗两颗螺钉。

39. 装可拆侧起落架。

40. 锁住可拆侧起落架前后根部。两处压帽与两颗M2×8；逐处锁紧。

41. 接好可拆侧按键支线并合壳。扶住窗端插壳并接妥支线，留插拔余量，不拉针或夹线；尾头和后部一体定位舌槽先对正，沿-Y平推合壳。导入斜面辅助定位，不用螺钉硬拉错位的壳。热桥接触面薄涂非固化绝缘导热材料。

42. 从前口锁紧前上锁壳螺钉。一颗M2×8，轴沿Y；用指定1.5mm超短臂L形内六角扳手分次转动。先手工放入并带正螺纹，不强行歪拧。

43. 从底口锁紧后下锁壳螺钉。一颗M2×8，轴沿Y；两颗交替收紧，使Y=0拼缝承靠面贴合，不能把电路板、电池或导线夹在承靠面内。

44. 试装通过后装前透光片。采用可剥离点胶。

45. 试装通过后装底透光片。两颗锁壳螺钉均锁紧并试装通过后，以可剥离点胶固定到负Y半壳。检修时与前片一起取下，不能再按保留底片的旧顺序操作。最终封壳样机仍须测试温升、照度、保护及充电互锁。

## 检修

先撤下整灯、断USB、关灯扇；取下前、底透光片并拔J2。使用指定超短臂1.5mm内六角扳手，从前口与底口逐颗松开两颗M2×8。各先沿+Y退出8.5mm，再分别向机头与下方取出；已脱牙螺钉手工拿出，不让它掉进电路。扶住可拆侧窗插壳，平移侧壳，释放按键支线，不以导线吊住壳。正常开壳不拆吊杆、M4承重连接、磁铁、轴承或皮带。

取整架时再解皮带和固定侧按键支线，松扎带/胶带，将柔性支线停放在壳外，支撑内架后卸唯一固定螺钉，沿+Y取出。SHELL温度探头随热桥，不粘活动侧壳。换芯、取控制板及拆热桥均在壳外操作。

几何路径检查不代替打印公差、紧固扭矩和抗拉/振动实测。两颗螺钉应交替收紧至拼缝贴合，PETG导孔不得过拧或反复磨损后继续使用。
