Cailynoo7/makit-project-6/manufacturing/helicopter/drawing/machining-notes.md

# 直升机灯15件铝导热组件加工说明

适用机身版本47a887e8，与15页A3加工图及同版STEP配套。每个AL编号各1件，共15件，不采购重复总成。STEP保留整机坐标：球心为[0,0,0]，机头-X、尾部+X、上方+Z，单位mm。复杂曲面、切口、让位和左右差异由该版STEP定义；不得量纸图缩放制造。

## 通用工艺与公差

材料采用1050/1060导热铝，主体机加工；薄衬片名义0.50mm，先球面成形、再按三维轮廓修边。球面片是双曲率，不能直接激光切一块平片就作为成品。本资料不提供未经验证的展开DXF。整体切削优先报价；若提出分块钎焊后精修方案，先提交接头位置与工序供复核，不自行改变热通路或装配面。

工程默认：一般线性±0.10；孔中心坐标±0.05；接触尺寸±0.05；平面接触面平面度0.05。装配限制轮廓以STEP为最大材料包络，只允许向少材料侧偏差0.10，优先于可能侵入配合间隙的普通对称公差。球面按曲面轮廓检验，不套用平面度。标注为不同半径的热接触面不可擅自改成同一球面。

内衬外球面R≤47.45、内球面R≥46.95、成形后局部厚度≥0.40；不得通过堆厚胶或把零件压翘来装配。其他棱边倒钝0.10–0.20，薄衬片贴合边只轻去毛刺，不大倒角使薄片消失。接触面精修、脱脂干燥、无压痕/毛刺，不在热接触面喷漆、厚阳极或贴保护膜交装。

所有M2为M2×0.4-6H，底孔Ø1.60；M1.6为M1.6×0.35-6H，底孔Ø1.25。CAD中Ø2/Ø1.6表示螺纹大径包络，不按光孔直接交货。攻牙后清除切屑、通规手检；浅铝牙手动轻拧，禁止电批强扭。孔口轻去毛刺，不扩大有效牙段。

## 零件、基准和关键加工

AL01：COB集热板，18×34×3，范围X=-37..-19、Y=-17..17、Z=0..3。以Z=0下平面为COB接触面，中心[-28,0]。两M2通牙轴心[-28,-14.5]/[-28,14.5]，Y孔距29；两Ø1.9支座间隙孔[-23,-10.5]/[-23,10.5]，孔距21。12×12的COB胶面平整清洁，不加工影响发光方向的额外凸台。

AL02/03：左右铝导热桥，各1。两接触螺钉轴线左[-28,24]/[27,24.5]，右Y反号；X距55、Y错位0.5，不把孔连成同一Y排。Ø1.9通孔，顶面Z=24处Ø3.4沉孔深1.7。根部与集热板接触面Z=3.1，填0.1mm非固化导热材料；两M2间隙位于[-28,±14.5]，根部接触槽6.4×2.4、侧避让8.4×4.4按STEP。侧边NTC出线为R4开放圆槽，槽轴线X=13.35、Z=24.135、沿Y；保留下方连续金属腹板，不扩大为贯穿裂口。所有分支和轮廓按STEP，不以简单折片替代。

AL04/05：上盖左右导热连接件，各1。下搭接面Z=26.10，与桥顶之间0.10分离热界面，不胶死下搭接。上端球面R46.85贴上盖内衬；仅上端胶合。左右方向及窗口避让按STEP，不能互换后强压上盖。

AL06/07：左右前接触座，各1。M1.6通牙轴心[-28,±24]；与桥贴合的平面及球面R46.85按STEP。接触座与内衬间0.1mm非固化填料，便于检修；不可永久胶在下壳。

AL08/09：左右后接触座，各1。M1.6通牙轴心[27,±24.5]；其余要求同前座，但轮廓不同，不拿前座反向代替。

AL10/11：左右前壳内衬，各1；AL12/13：左右后壳内衬，各1；AL14/15：左右上盖内衬，各1。全部名义厚0.50，球面外R47.45/内R46.95。左右局部缺口不同，保留所有窗口、螺钉、起落架根部、接缝、充电与天线避让。上盖片不能跨越检修缝。成形后修边，不得用未成形平片和大量胶代替。

## 热界面与交验

COB下方12×12×0.15绝缘导热胶，k≥1.5W/mK；内衬贴壳胶≤0.15。桥根、桥/接触座、接触座/内衬及上盖分离搭接用0.1非固化绝缘导热填料，k≥3。金属件净重按2700kg/m³约40.083g；称重仅作漏件/错材提示，不代替尺寸或材质证据。

交件逐件标AL编号（标在非接触面，可用可移标签），配材料记录和孔/螺纹、平面/球面检查结果。用与该版一致的打印机壳干装：窗口、螺钉和导线无被挤压，桥能内移10.4再向上退出；先释放并取下线束夹，防止右桥被夹挡住。四个接触座各内移12再向上退出。上盖下搭接能无撬动分离，检查薄胶层能够连续接触，而不是仅角点承靠。

本套图为三视图、虚线和等轴测，无剖视/局部辅助视图；隐藏特征及曲面仍需三维STEP辅助加工。报价应注明15件全部、材料、成形工装、攻牙、去毛刺、干装检查和交期；当前没有工厂报价或热性能保证。整机热稳定照度、外壳及电池温升按首样验收，不能由加工尺寸通过推定散热合格。
