Cailynoo7/makit-project-6/product/firmware/commissioning/首样通电与温度校准.md

# 首样通电、故障模拟与三路温度校准

本流程用于当前XIAO ESP32C3程序及连接板171fcced55d57308fe0ba67341bcf9a1e5120fcf6a640abfc35d908bb5440812。它是待执行的实验步骤，不是实测合格报告。保持外观、电路和正式程序不变；测试用转接线、模拟电阻和50%试验副本均须在结束时撤除。先在桌面固定机身，不磁吸悬挂；本流程不包含磁吸承载或旋翼风量验收。

## 1. 准备与记录

仪器：
- 0–5V、至少3A、可调限流且输出与保护地隔离的直流电源；普通电源不作为可吸收充电电流的电池模拟器。真实电芯暂不接入。
- 输入阻抗≥10MΩ万用表；示波器或3.3V兼容逻辑分析仪，至少5通道、建议≥2MS/s，可被动解码100kHz I²C。
- 校准过的多通道温度记录仪，细线绝缘热电偶，误差预算≤±0.5℃；恒温干井/干式恒温块。红外测温可寻找热点，不能直接用亮铝反射面的红外读数做校准基准。
- 三只10.000kΩ、0.1%参考电阻；精密电阻箱或可先调整后接入的支路电阻，分辨率约1Ω、实测误差≤0.1%；绝缘测试转接线。
- 三只NTC、实际COB及完整铝导热组件、无旋翼电机；后期才装真实点焊包覆18650。
- 可控的5V USB电源供最终充电互锁测试；不用普通直流电源与USB同时给BAT端供电。

记录：在test-results.csv填实际观察、波形文件名和pass/fail/未执行；在calibration.csv填原始码、参考温度、实测3V3及稳定状态。每组记录环境温度、PCB版本、固件配置哈希、仪器型号、日期。所有空白均未测试，不能直接勾通过。

没有逻辑分析仪时可先做极性、电源和万用表预检；只能由电压粗算温度，不能声称已核实ADC通道、时序及实际温控逻辑。

## 2. 先确认地线与测量点

|项目|接法|
|---|---|
|台式电源正/负|J2.1 CELL_P / J2.2 CELL_N，替代电芯；不是J12|
|XIAO BAT+/BAT−|J12.1 VBAT / J12.2 PACK GND，保留保护路径|
|全部示波器/分析仪公共地|只接J1.7或J12.2 PACK GND|
|灯EN控制|XIAO D4/GPIO6到J1.4；板内经100Ω至TPS61500 EN|
|风扇输入|D3/GPIO5到J1.3 IN1；D5/GPIO7到J7.1 IN2|
|USB检测|J1.5到D10/GPIO10；J1.6取XIAO VBUS|
|ADC|J8.1=3V3，J8.2=SDA/GPIO20，J8.3=SCL/GPIO21|
|模拟探头|J9/J10/J11的1脚为采样，2脚为PACK GND；对应COB/SHELL/BAT|
|COB|J4.1 LED+ / J4.2 LED_FB；LED_FB不是地|
|电机|J3两脚为H桥两输出；两根均不是地|

不把RAW CELL_N、LED_FB或电机端子当仪器地。台式电源输出若与保护地硬连接，示波器/电脑接地可能绕过低端保护MOS；换用合适的隔离电源/隔离差分仪器，不拆仪器保护地。COB电压跨两端用差分探头或浮置万用表量；电机用差分或电流探头测，不夹普通示波器地到H桥输出。

断电时安装夹具并包好裸端，再上电。更换COB、电机、J8整插头、探头接线均先断电；运行中的“开路/短路”只操作预装绝缘开关，不能用表笔随手短接。尤其不能短接J2/J12/J4或3V3。

## 3. A：断电检查

1. USB、电池、电源全部断开；电容放电后测量。检查芯片方向、焊桥、锡珠、绝缘和端子极性。
2. 检查J2/J12无明显短路；电容充电会让阻值变化，不用固定欧姆数代替判断。确认CELL_N与PACK GND没有接线短路，所有负载和XIAO在PACK侧。
3. 三只真实NTC在室温的阻值应与10k/B3950规律相符；25℃约10kΩ。标好COB/SHELL/BAT，不能仅按线颜色猜。
4. J3暂不接电机，J4暂不接COB。用测试转接线断开“XIAO GPIO6→J1.4”这一根灯控制线；板侧EN仍由原下拉保持低，其他J1线不动。后面逻辑模拟只观察XIAO侧GPIO6，功率级不会因按灯键启动。
5. J9/J10/J11各接一只10.000kΩ参考电阻。预先接好仪器地、SDA/SCL和三路控制观察线；各信号端均为高阻输入。

## 4. B：首次限流通电和ADC基准

1. 电源输出关闭，设3.80V、限流0.20A，接J2；保持USB和真实电芯断开。开启电源后，灯板侧EN、IN1、IN2应为低，无反复重启。
2. 若进入恒流模式、PACK电压跌落、器件异常发热或复位循环，立即关电排查；不凭“电源不够”继续加限流。记录空载电流，先观察60秒。
3. 万用表量J12.1对PACK GND，记录实际PACK电压；J8.1应接近3.3V。3V3偏离3.30V超过约0.05V、带载明显变化时先查稳压和供电，不能靠温度偏移掩盖问题。
4. 被动解码地址0x48（有的分析仪显示8位写90/读91）。观察配置寄存器指针01、配置C383/D383/E383/F383，分别选AIN0/1/2/3。OS未就绪的配置读数可能为4383/5383/6383/7383；不是错误通道。
5. 每次“指针00后读两个字节”才是转换结果，高字节在前。根据最近一次正确配置写入确定通道，不把指针01返回的配置字当ADC码。正常完整一轮约36ms、每100ms开始下一轮。
6. 三路10k时，电压约实测3V3的一半；以默认3.300V计算为1.650V、十进制13200（0x3390）、25℃。AIN3在PACK3.80V时约1.900V、15200，电池换算约3.80V。
7. 电阻、ADC基准、通道或测量地不吻合先停在此处。校准3V3后10k应读25℃加当前探头偏移，而不是强行把所有结果调成25℃。

当前正式程序没有串口数据输出，不能期待串口监视器自动显示温度；GPIO20/21已用于I²C，不能再接UART调试。分析仪只被动监听，不加第二个I²C主机或额外5V上拉。

## 5. C：按键、输出波形和启动中断

保持J1.4断开的转接状态、J3/J4无负载。此阶段只证明控制信号，不证明灯源实际关断。

1. 上电后等至少6秒，确认两路仍为关闭；短按左键仅GPIO6变高，短按右键仅IN2变高且IN1出现20kHz波形。长按2秒不连发，两键同时短按可同时开。
2. 风扇运行时IN1高约40.04%、低约59.96%；IN2恒高。关闭后两者均低，下一次启动前实际低电平≥10ms。不从IN1“高电平比例”直接判断风扇驱动比例。
3. 正式程序冷机100%灯EN会一直高，没有50ms后的边沿；它不应一直输出5kHz方波。只有降额后才出现5kHz。
4. 为看清50ms阶段，在正式程序副本仅把kLightMaxPermille改500。可用下述工具生成副本，正式源码不变：
   `python3 commissioning_helper.py limited-build limited-build/helicopter_controller`
   用Arduino IDE打开生成副本并选择同一XIAO板型烧录；按键开灯，预期连续高≥50ms后出现5kHz、约50%高电平；关闭立即低，重启前低≥10ms。
5. 在50ms阶段内制造USB检测高（见下一节的检测夹具），预期GPIO6、IN1、IN2降到低；等待50ms完成不能阻塞关闭。重复按住键上电、插入、拔出和两键同时动作。
6. 试验副本仍有满电流启动段；“50%”不能代替散热。所有逻辑波形确认后恢复正式100%程序，移除测试副本影响；以烧录文件/源码哈希区分两者。

## 6. D：电阻模拟温度与传感器故障

### 不产生开路的温度夹具

每个探头接口保留固定10kΩ接1/2脚；额外一条“开关+Rb”支路并联到这只10k上。先断电接好夹具，支路开关断开时为25℃，闭合后得到高温等效阻值。切换不同Rb时只断开支路，固定10k始终不断，避免电阻箱换档瞬间的开路误触发故障。

Rb可用精密电阻箱，先在支路断开时设值，再闭合。真实参考10k有误差时按实测值计算并联；表值按固定10.000k及默认零偏移计算，测试前万用表复核。下表不是把Rb直接替代NTC：

|模拟通道/状态|等效NTC|并联支路Rb|预计ADC节点|正式灯指令|
|---|---:|---:|---:|---|
|COB 65℃|2086.37Ω|2636.43Ω|0.56965V|5kHz，高约62.5%|
|COB 70.5℃|1730.61Ω|2092.79Ω|0.48685V|两路低|
|SHELL 45.5℃|4264.25Ω|7434.51Ω|0.98652V|5kHz，高约62.5%|
|SHELL 48.5℃|3798.66Ω|6125.56Ω|0.90846V|两路低|
|BAT 42.5℃|4797.43Ω|9221.27Ω|1.06988V|5kHz，高约62.5%|
|BAT 45.5℃|4264.25Ω|7434.51Ω|0.98652V|两路低|

完整表thresholds.csv包含开始点前0.5℃、开始点、中点、关断前0.5℃、关断后0.5℃及恢复点。量化和仪器误差使边界值可能差一档，优先用两侧0.5℃点夹逼，并由实际ADC码计算显示温度。后续改过电源/偏移时，运行工具重新生成，不能继续沿用旧表。

### 每路相同执行一次

1. 其他两路保持10k，PACK3.8V，等6秒后先用按键打开灯扇，再闭合本路中点支路。灯变为5kHz约62.5%，风扇保持原状态。切回25℃，已运行灯可恢复高电平。
2. 再模拟关断后0.5℃，预期两路控制低；按键不能启动。
3. 模拟“刚过关断又略降回关断以下”，但仍高于恢复点，持续6秒，仍不能开机；不要误把未到恢复条件当程序坏。
4. 最后回到25℃，等6秒，仍不能自动开。先松键，再短按，两路分别能开。COB/SHELL/BAT的恢复上限分别55/40/37℃，电芯还需≥5℃、电池需3.5–4.25V。
5. 另用夹具预装的串联断开开关制造本路开路，再用独立预装开关仅短接该NTC接口1/2脚。两种各重复3次，应关闭两路；恢复10k并等6秒，必须重新按键。
6. 在模拟高温降额区先关闭灯，再按灯键应拒绝重新启动；风扇在未达硬关断时可独立开。温度回落后仍需重新按灯键。
7. 电芯低温只用电阻模拟：断电把J11接约35.45kΩ（约−1℃），上电不能启动；恢复10k后重测。不要冷冻或加热真实电芯做故障。

在温度硬故障时采样器会提前中止该轮，后续通道暂时没有数据属于预期。程序把提前高温、配置/通信失败都作为禁止负载的采集失败路径，不要求出现某个可见故障码。

### ADC和供电故障

- ADC失联：断电装好仅串在J8.2 SDA上的开关，3V3/GND/SCL保持正确。两路指令运行时断开SDA，下一次事务NACK/超时应关闭两路；恢复后等6秒仍不自动开。不要运行中拔J8整插头。
- 初次通电即ADC缺失、任一NTC开路：不允许按键开。不要通过把健康标志写死为真来绕过。
- 记录从开关动作/对应数据读入到三路控制低的时间。首样排查门限：故障夹具动作到关闭≤0.5秒，USB检测GPIO变高到关闭≤50ms；这是含余量的工程测试上限，非产品安全认证。超过即停查采集调度/接线，不修改阈值让其通过。
- 单独的数据陈旧、OS忙超时、错误配置回读、GPIO/LEDC错误及millis回绕，目前用主机自动测试覆盖；SDA断线只证明通信故障，不能算已实测250ms数据陈旧分支。若未用专门I²C从机模拟器注入，就在记录表写未执行。
- 低压：不用真实电芯。恢复正式程序和三只10k，在台式供电下从3.8V逐步降到3.35，再每次0.02V降低；用AIN3及J12读数夹逼3.3V。低于阈值两路关闭。升到3.45V等6秒仍不能启，再升到3.60V等6秒，需重新按键。电源保持CV，不把电源限流导致的复位当成软件低压关断。
- 过压：不要把XIAO或真实电芯升到4.30V以上。仅在功率级隔离、实际PACK3.80V时，由具备焊接能力的测试人员断电在R26上臂100k两端装预接绝缘开关+300k支路。并联后上臂约75k，AIN3约2.171V，程序看到约4.343V，实际PACK仍3.80V，预期关闭；断开支路恢复正常，等6秒并重新按键。夹具装不可靠则此项写未执行，不能用真实过充替代。结束断电拆除所有分压夹具。

## 7. E：USB互锁测试，避免普通电源被倒灌

台式电源供J2时，不直接给XIAO插USB：XIAO充电器可能向BAT端送电，而普通电源不能吸收。

台架检测测试可用预接转接线断开“XIAO VBUS→J1.6”，将独立隔离5.00V、限流5mA电源只接板侧J1.6，负极PACK GND；J1.5仍接GPIO10。不给XIAO 5V端供电，不把5V接到GPIO或ADC。
- 从两路指令开启状态加5V，板侧检测约3.0V，三路控制低。
- 去掉模拟VBUS，确认检测低持续至少500ms，仍不开机；先松键再按才开。
- 插拔抖动、按住不放、按键恰逢插入均不排队复开。
- 完成后断电恢复原VBUS线；模拟只验证分压/软件，不等于真实USB插合验证。真实USB接入留到正常电芯、充电受监控阶段。

## 8. F：第一次接COB与电机

先完成故障逻辑，不用实际过热触发关断。全部电阻/分压/USB/SDA故障夹具撤除，接回三只真实且贴牢的探头，恢复正式程序。COB必须已粘合18×34×3mm铝集热板、导热桥与内衬；禁止裸COB悬空长亮。

1. 断电恢复GPIO6→J1.4。接好COB到J4，先不接电机；参考热电偶置于COB Ts附近。不要带电插拔COB，不向LED_FB夹仪器地。
2. 电源设3.80V、限流1.8A作为单灯首样起点。起动若进CC、跌压、反复复位即停；不要把限流后的电流当正常效率。首次点亮1秒关，再10秒、60秒，记录输入功率、COB电流/反馈和温度。
3. 优先测LED_FB对PACK GND的直流反馈电压；正式满亮名义约0.200V，经实际采样电阻0.75Ω换算约267mA。万用表量电阻要断电。初步排查范围257–276mA为电路器差预算，实物先以0.28A作为停查线，计入仪表误差；不得因灯暗盲目提高电流。
4. 电机独立测试：灯关闭，断电接J3，保持主旋翼和皮带拆下。3.80V、限流0.5A起步，先点动1秒，看方向和电流；CC或异常噪声停查。电机两线不能接地。安装传动/旋翼后的绕组RMS验收≤0.375A另做，电池侧平均电流不能替代绕组RMS。
5. 灯、电机分别正常，再在固定夹具中同时工作，电源限流2.5A为台架默认起点；记录是否CV、PACK、3V3和温度。此时仍不装主旋翼。
6. 已接负载后，只复测安全的USB模拟和预接NTC开路故障，确认实际电流随EN/IN2关闭而下降；不要把真实探头全部替换成25℃电阻后长时间照明。NTC脱离热件不能用来做长时间功率试验。
7. 关闭灯后COB输出可能仍有残压；无输出隔离开关的升压拓扑不保证关灯后LED+等于0V。断USB/电源，万用表确认残压已消退再换线，不拿输出短路来放电。

台式电源限流档是首样保护条件，不是产品额定电流；本流程不测试熔断、真实短路、过充或电池保护MOS极限。

## 9. 三路校准：先电气，再实际贴装

### 9.1 校准3V3与电池比例

输出关闭、NTC处于稳定室温。记录J8.1实测值，必要时将kNtcSupplyV改为该板实测供电值；在3.6/3.8/4.2V、单灯和灯扇状态再量一次，差异>0.03V需检查供电或评估测温误差，不能用一个偏移掩盖随电压变化的误差。
电池比例候选值：
`kBatteryDividerGain = 万用表测得的PACK电压 / (AIN3有符号码 × 0.000125)`
在至少3.6、3.8、4.2V核对；校准后电池误差首样目标≤0.03V。ADC输入与万用表节点差异首样目标≤5mV；不符先查采样量程、引脚、地和仪表，不能靠改B值补偿。

### 9.2 电气/珠头校准

1. 电芯暂不装；供电仍来自台式电源，灯功率级控制断开。每次只把被测的一只NTC放进干式恒温块，另两路用10k，避免前面通道硬超温使后面通道无读数。不得浸湿COB、已装机电池或连接板。
2. 参考热电偶与珠头紧邻、均温、可靠绝缘，不能用热风枪直接吹一个点。COB探头测约25/45/60℃；壳体探头约25/35/45℃；电芯探头作为独立探头测约25/35/40℃，不是加热电芯。
3. 每点至少等待3分钟，并要求参考温度60秒内变化≤0.2℃后取30秒数据；仍不稳定则继续等待/改夹具，不填stable=yes。硬温限会使输出禁用，不妨碍监听被测通道已经读出的原始码。
4. 由被动I²C取该通道原始码，输入工具reading换算；填stage=electrical、probe、reference_C、raw_code、rail_V、stable=yes。不要填目标设定温度代替实际参考温度。
5. 初步传感器误差目标±2℃。不能凭单点在25℃对齐就宣称60℃也准确；若误差随温度变化明显，检查B值/分压/3V3及传感器，不强行只调偏移。

### 9.3 实际贴装与目标温度映射

全部恢复真实探头及散热结构。热电偶始终与NTC同时记录，依次做关灯冷态、单灯稳定、灯扇稳定；不靠人为加热电芯制造高温。每路尽量取得至少3个稳定工作点，跨度不足则只记录现有范围，不宣称全范围校准。

- COB：现有NTC贴基板边缘；参考热电偶贴厂商第3页所标Ts点，即靠近负极焊盘的小测温点。不是发光胶面或任意铝板位置，也不是LED结温Tj。Ts/负极区域带电，必须用绝缘细线探头或差分隔离测温器，不能借热电偶把LED_FB接到地。不能因此覆盖光面、挤开导热层或短接焊盘。
- 壳体：现有NTC贴后部铝内衬。先扫描机身、窗口、顶部、底面和尾根找最热的可触表面，再将接触热电偶固定该热点。相同功率下比较NTC与最热外表面；若热点转移，取最不利情况。亮铝上的红外误差不能作为通过依据。
- 电芯：采用已点焊并绝缘的实际电芯，参考热电偶与NTC并列贴同一筒身，聚酰亚胺带和薄绝缘导热材料保持接触，不覆盖泄压端和极柱。固定座/绑带按最终方式安装。校准阶段让电芯自然温升，首样电芯到42℃即人工停测；45℃关断用电阻模拟证明。

读数用当前配置换算；计算总偏移时先扣除已有kTempOffsetsC，避免重复累加：
`候选总偏移 = max(0, 所有稳定点的最大[参考目标温度 − 零偏移换算温度] + 0.5℃)`
0.5℃是参考仪器误差预算的默认余量，不是任意降低温限。电气点和贴装点都纳入；不建议负偏移把保护延后。若所需偏移>5℃、温差跨度>2℃或加偏移后过读>2℃，先改善安装/导热路径或建立更合适的校准模型，不能直接放宽关断温度。

工具calibrate只给候选值和问题提示，不改程序，不把缺数据算通过。把候选值写入kTempOffsetsC[COB,SHELL,BAT]后需重新编译、烧录并复跑电阻阈值测试；阈值表要随偏移重算。尚无实测时保持0，不伪造校准值。

### 9.4 响应时间与脱落风险

供应商液体中时间常数≤15秒不代表贴壳实装也≤15秒。以灯功率阶跃记录参考温度与NTC的上升曲线，至少1Hz采样；电流波形另用示波器。记录到达相应减光值的延迟和停灯后的余热峰值。任何时候目标真实温度已到人工停测线，而程序读数仍明显偏低，停止并改探头位置/粘接；不能靠静态偏移掩盖动态滞后。探头松脱后仍可能读出正常室温，开短路检测无法发现这种情况。

## 10. 真实电芯与USB、封壳试验

只有电气预检、故障模拟、单灯/电机和贴装校准通过后才换真实18650。
1. 断开USB及台式电源，把真实电芯接J2；取消一切模拟分压/电阻。确认正常室温及5秒就绪，按键开灯扇。第一次仍固定在台面、不装旋翼。
2. 接真实5V USB，确认USB检测约3V、灯扇实际停止。拔线至少500ms仍不恢复，重新按键才启动。不能用“正在充电所以电源电流变大”否定负载是否关闭，要同时看EN/IN2及负载电流。
3. 充电期间监测电芯、XIAO充电器和外壳，首样电芯≥40℃、异常升温或任何异常立即人工拔USB。程序没有充电关闭权限；电芯厂商0–45℃充电范围不能由本固件强制保证，禁止故意加热充电电芯测试45℃。
4. 固定最终壳体、铝接触界面、真实透光片和线束，采用计划使用姿态单灯、灯扇分别测试。旋翼测试需完成动平衡/旋转防护/绕组电流检查，未做时只可认定无旋翼的电气与热预试，不能代替最终风扇热环境。
5. 环境25℃记录0/1/5/10/20/30分钟数据，随后继续至连续10分钟温度变化<1℃、功率也稳定。若30分钟仍在升温，延长测试，不能按到时就合格。每个模式先冷却至接近环境温度。
6. 首样人工停测线（工程默认、比故障硬限更保守）：COB Ts≥65℃、最热外壳≥45℃、电芯≥42℃；充电电芯≥40℃另适用。触线立即停、保存波形，不能等程序硬限才处理。这不修改产品温限或验收目标。
7. 热稳定后使用实际透光片，在底透光面到桌面300mm、400×300mm区域的均匀20点中心网格测照度。建议5列×4行，点坐标X=−160/−80/0/80/160mm，Y=−112.5/−37.5/37.5/112.5mm。分别记录关灯环境和开灯总照度，工程净照度用同点相减，环境不变。平均≥500lx、最小≥300lx、最大/最小≤3；记录测试姿态及灯是否降额。桌面区域与前后方向自行标明，不把网格X与CAD轴混用。
8. 若因温控降额导致热稳定照度不足，不把冷机刚开灯数值作为合格，也不提高温限掩盖不足；记录热路/光学改进需求。

## 11. 结果交回与恢复

结束先关负载、断USB和电源，确认残压。撤除所有电阻、R26并联、SDA断线、模拟VBUS、GPIO6隔离等夹具，恢复逐线表和三只探头。正式烧录仅使用核对过哈希的当前配置；试验副本的500上限不能当正式1000上限验收。

交回test-results.csv、calibration.csv、波形截图/原始采样和稳态温度/照度记录；如有失败，保留故障发生前后的数据，不先改温限。可以直接把记录内容发给设计助手，由其复核候选偏移、重编译并更新验证记录。尚未测量的项目写未执行，不能由软件测试替代。

## 12. 工具命令与依据

在本手册所在文件夹运行：
```sh
python3 commissioning_helper.py thresholds
python3 commissioning_helper.py reading --probe COB --raw 13200
python3 commissioning_helper.py reading --probe VBAT --raw 15200
python3 commissioning_helper.py calibrate calibration.csv
python3 commissioning_helper.py limited-build limited-build/helicopter_controller
```
原始码可填十进制或0x开头16位十六进制；自动处理有符号数。thresholds读取正式ControlConfig.h，并非固化另一份温限。CSV不是自动从设备采集，须手工填入被动采集的读数。

依据：现行接线表与正式源码；[TPS61500手册第11页](https://www.ti.com/lit/ds/symlink/tps61500.pdf)，[ADS1115 Rev.E第24–26页](https://www.ti.com/lit/ds/symlink/ads1115.pdf)；项目HNTC探头手册第1页（10k/B3950/热响应）、COB手册第3/8页（Ts测点/温度）、FLY18650-3200手册第4页（充电0–45℃）。首样限流、人工停测值、偏移余量、计时排查线及校准误差目标均为source=default工程试验条件，不是厂家额定值或已实测结果。
