Cailynoo7/makit-project-6/product/firmware/commissioning/calibration.csv

stage | probe | target_C | reference_C | raw_code | rail_V | stable | note
electrical | COB | 25
electrical | COB | 45
electrical | COB | 60
electrical | SHELL | 25
electrical | SHELL | 35
electrical | SHELL | 45
electrical | BAT | 25
electrical | BAT | 35
electrical | BAT | 40
installed | COB |  |  |  |  |  | cold
installed | COB |  |  |  |  |  | light_stable
installed | COB |  |  |  |  |  | light_fan_stable
installed | SHELL |  |  |  |  |  | cold
installed | SHELL |  |  |  |  |  | light_stable
installed | SHELL |  |  |  |  |  | light_fan_stable
installed | BAT |  |  |  |  |  | cold
installed | BAT |  |  |  |  |  | light_stable
installed | BAT |  |  |  |  |  | light_fan_stable
