Cailynoo7/makit-project-6/product/firmware/commissioning/test-results.csv

id | procedure | expected | observed | result | capture_or_note
A01 | 断电极性/绝缘/保护接线 | J2 RAW与J12 PACK区分，所有仪器地为PACK，COB负极不接地
B01 | 3.80V/0.20A首次供电 | CV稳定，输出关闭，无复位/异常发热
B02 | 空载电流与3V3 | 记录实际电流、PACK、3V3；异常先排查
B03 | ADS1115通道与配置 | 0x48；C383/D383/E383/F383正确对应四通道
B04 | 三只10k及电池电压 | 原始码/电压吻合实际3V3与PACK
C01 | 按键独立/长按/同时按 | 独立切换，长按不连发，启动需健康5秒
C02 | 风扇极性 | 20kHz IN1高约40%；IN2运行高；关闭均低
C03 | 正式100%灯波形 | 冷机持续高，降额才5kHz
C04 | 50%测试副本启动时序 | 连续高>=50ms后5kHz/约50%，再启动前低>=10ms
C05 | 50ms启动中USB模拟 | 不等待启动完成，三路控制关断
D_COB_SOFT | COB软降额/温度回落 | 先启动再模拟中点，灯约62.5%，风扇不受软降额影响
D_COB_TRIP | COB硬温限 | 超过关断0.5℃后两路关闭，按键不能启动
D_COB_RECOVER | COB回差/恢复重按 | 仍高于恢复点不能开；全部正常5秒后仍关闭，重新按键才开
D_COB_OPEN | COB开路x3 | 两路关闭，恢复后重新按键
D_COB_SHORT | COB短路x3 | 仅NTC接口两脚短接，关闭两路，恢复后重新按键
D_SHELL_SOFT | SHELL软降额/温度回落 | 先启动再模拟中点，灯约62.5%，风扇不受软降额影响
D_SHELL_TRIP | SHELL硬温限 | 超过关断0.5℃后两路关闭，按键不能启动
D_SHELL_RECOVER | SHELL回差/恢复重按 | 仍高于恢复点不能开；全部正常5秒后仍关闭，重新按键才开
D_SHELL_OPEN | SHELL开路x3 | 两路关闭，恢复后重新按键
D_SHELL_SHORT | SHELL短路x3 | 仅NTC接口两脚短接，关闭两路，恢复后重新按键
D_BAT_SOFT | BAT软降额/温度回落 | 先启动再模拟中点，灯约62.5%，风扇不受软降额影响
D_BAT_TRIP | BAT硬温限 | 超过关断0.5℃后两路关闭，按键不能启动
D_BAT_RECOVER | BAT回差/恢复重按 | 仍高于恢复点不能开；全部正常5秒后仍关闭，重新按键才开
D_BAT_OPEN | BAT开路x3 | 两路关闭，恢复后重新按键
D_BAT_SHORT | BAT短路x3 | 仅NTC接口两脚短接，关闭两路，恢复后重新按键
D16 | 降额区拒绝灯冷启动 | 拒绝满HIGH启动，风扇可独立开
D17 | 电芯低温电阻模拟 | 约35.455k代表-1℃，禁开；不冷冻真实电芯
D18 | SDA断开/上电ADC缺失 | 通信失败关闭，两路不自动复开；记录实际延迟
D19 | 台式供电低压 | 低于3.3V关闭，3.45V不恢复，3.60V稳定5秒后需重按
D20 | R26并联模拟过压 | 实际PACK3.8V不变，ADC约2.171V，禁止负载
D21 | 孤立stale/OS忙/配置异常/HAL错误 | 主机测试覆盖；无专用模拟器时实物记录未执行
E01 | 板侧VBUS模拟 | 实际分压约3V，关闭；拔线稳定500ms不自动开
F01 | 实际COB1秒/10秒/60秒 | 完整热路，电源CV，电流和温升受控
F02 | 反馈电压与COB电流 | 名义200mV/0.75Ω；超0.28A停查并计仪器误差
F03 | 无旋翼电机点动 | 方向正确，无异常噪声/CC/复位
F04 | 双负载与实际关断 | 记录PACK/3V3/输入电流；安全故障后实际电流下降
G01 | 3V3和电池比例校准 | 至少3.6/3.8/4.2V，电池误差目标<=0.03V
G02 | 珠头电气校准 | 各通道>=3稳定点，记录原始码/参考温度
G03 | COB Ts贴装校准 | 测真实Ts，不将NTC边缘读数直接当Ts
G04 | 壳体热点贴装校准 | 最热可触外表面与内衬NTC比较，考虑热点转移
G05 | 电芯贴装校准 | 正常自然温升，参考探头与NTC并列，>=42℃人工停测
G06 | 动态滞后与停灯余热 | 记录阶跃曲线与峰值，不用静态偏移掩盖迟滞
G07 | 改校准参数后复核 | 重新编译/烧录/重算电阻表/重跑阈值
H01 | 真实电芯USB互锁 | 台式电源已断开，插USB实际关灯扇，拔线不复开
H02 | 实际充电监测 | 首样电芯>=40℃人工拔USB，软件无断充能力
H03 | 封壳单灯/灯扇热稳定 | 达到温度与功率稳定，保留实际运行状态
H04 | 带防护旋翼终态补测 | 若未做，不宣称最终风扇热环境验收
H05 | 20点热稳定净照度 | 300mm/400x300区域；平均>=500、最低>=300、最大最小比<=3
Z01 | 移除夹具/恢复正式程序 | 真实探头、J1.4、J1.6、SDA、R26恢复，核对配置哈希
