Cailynoo7/makit-project-6/product/firmware/commissioning/thresholds.csv

probe | point | display_C | ntc_ohm | parallel_to_fixed_10k_ohm | node_V | raw_code_approx | nominal_running_light_permille
COB | baseline | 25.0 | 10000.0 |  | 1.65 | 13200 | 1000
COB | recover | 55.0 | 2978.44 | 4241.84 | 0.757321 | 6059 | 1000
COB | below_dim | 59.5 | 2530.87 | 3388.44 | 0.666503 | 5332 | 1000
COB | dim | 60.0 | 2486.16 | 3308.78 | 0.657075 | 5257 | 1000
COB | mid_dim | 65.0 | 2086.37 | 2636.43 | 0.569652 | 4557 | 625
COB | below_trip | 69.5 | 1789.65 | 2179.74 | 0.500934 | 4007 | 287
COB | above_trip | 70.5 | 1730.61 | 2092.79 | 0.486847 | 3895 | 0
SHELL | baseline | 25.0 | 10000.0 |  | 1.65 | 13200 | 1000
SHELL | recover | 40.0 | 5301.47 | 11283.24 | 1.143344 | 9147 | 1000
SHELL | below_dim | 42.5 | 4797.43 | 9221.27 | 1.069883 | 8559 | 1000
SHELL | dim | 43.0 | 4703.42 | 8880.1 | 1.055624 | 8445 | 1000
SHELL | mid_dim | 45.5 | 4264.25 | 7434.51 | 0.986524 | 7892 | 625
SHELL | below_trip | 47.5 | 3946.97 | 6520.65 | 0.933894 | 7471 | 324
SHELL | above_trip | 48.5 | 3798.66 | 6125.56 | 0.908464 | 7268 | 0
BAT | baseline | 25.0 | 10000.0 |  | 1.65 | 13200 | 1000
BAT | recover | 37.0 | 5989.41 | 14934.0 | 1.236134 | 9889 | 1000
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
