Cailynoo7/makit-project-6/(list of files, drawings)

Other design files:
product/pcb-release-fit-comparison.json
