Cailynoo7/makit-project-6/(commit log)

2026-11-13 feat(product): prepare preassembled helicopter lamp prototype package
    [203cec51bb3c7537266c230459960bd4a061e18f3619b9e0358805bf63a08652.step, 25a187cee2fd6b966885ce825cd2f2b1daf1ff4ee3670edd3007ffb8a7f189af.step, 3b922791c27c8a41e3812bc7b78e72789767ffb378cc199997cc15294ea0fd2a.step, 4654e142e46567c1d5b3a369d0c9be4d100c70c75d63b8a40d4c83222489d82d.step, 4c64164c21ae9286e84e0b4873d2902ae02953202b7cdcb915145f316ab6aae3.step, 4e0aa490b5d737619f6fee8720de3aa324388a98d51f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]
2026-11-13 feat(cad): simplify self-assembly and record structural redesign
    [bom.csv, bottom.dxf, c1554283-easyeda-native.json, c544396-easyeda-native.json, model.step, pololu-mmgm-cb.step, top.dxf, tps61500pwp-supplier.step]
2026-11-14 fix(git): reconnect cleaned project to published history
    Preserve the current design and stop tracking ignored build outputs.
    Keep published ancestry so the next publication can fast-forward.
    [assembly.step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]
